drawsome1/Carousel/Team Assignments/Team Assignment 3/Files/StateMachine.pdf

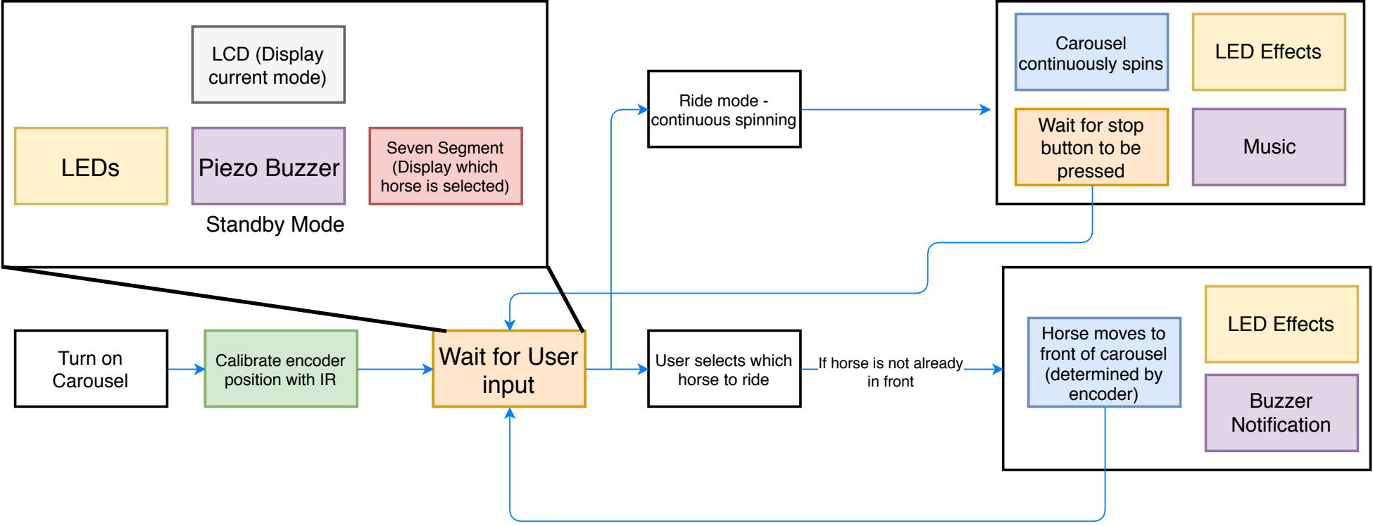
[picture p5: figure]
Standby Mode; Turn on Carousel; Calibrate encoder position with IR; Wait for User input; LEDs; Piezo Buzzer; User selects which horse to ride; Horse moves to front of carousel (determined by encoder); LED Effects; Seven Segment (Display which horse is selected); Buzzer Notification; Ride mode - continuous spinning; If horse is not already in front; Music; Carousel continuously spins; Wait for stop button to be pressed; LCD (Display current mode)

Module 1: LCD

Module 2: DC
Motor with
Encoder

Module 3: IR
Sensor

Module 4:

Buttons | Module 5: LEDs | Module 6: Seven Segment

Module 7: Piezo
Buzzer

## ECE 188 Team 1 State Machine
