drawsome1/Carousel/Codes/TeamAssignment3/PIDSineWave.PNG

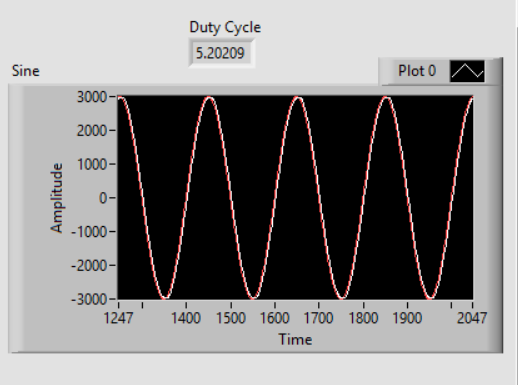
Codes/TeamAssignment3/PIDSineWave.PNG
