drawsome1/Carousel/Codes/TeamAssignment3/sinewave.PNG

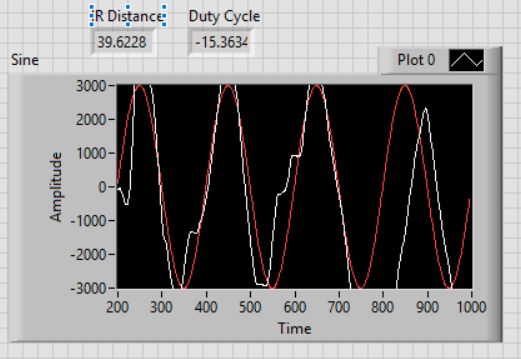
Codes/TeamAssignment3/sinewave.PNG
