drawsome1/Carousel/Pictures/5_kingdoms_disney_carrousel_dlp_canopy.jpg

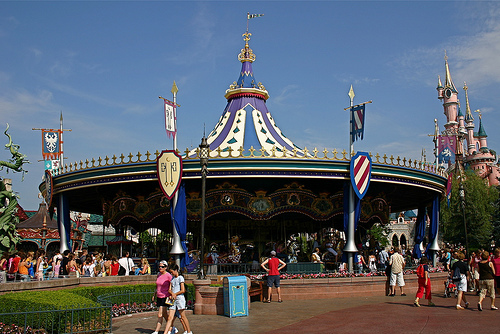
Pictures/5_kingdoms_disney_carrousel_dlp_canopy.jpg
