drawsome1/Carousel/Pictures/20180425_105059.jpg

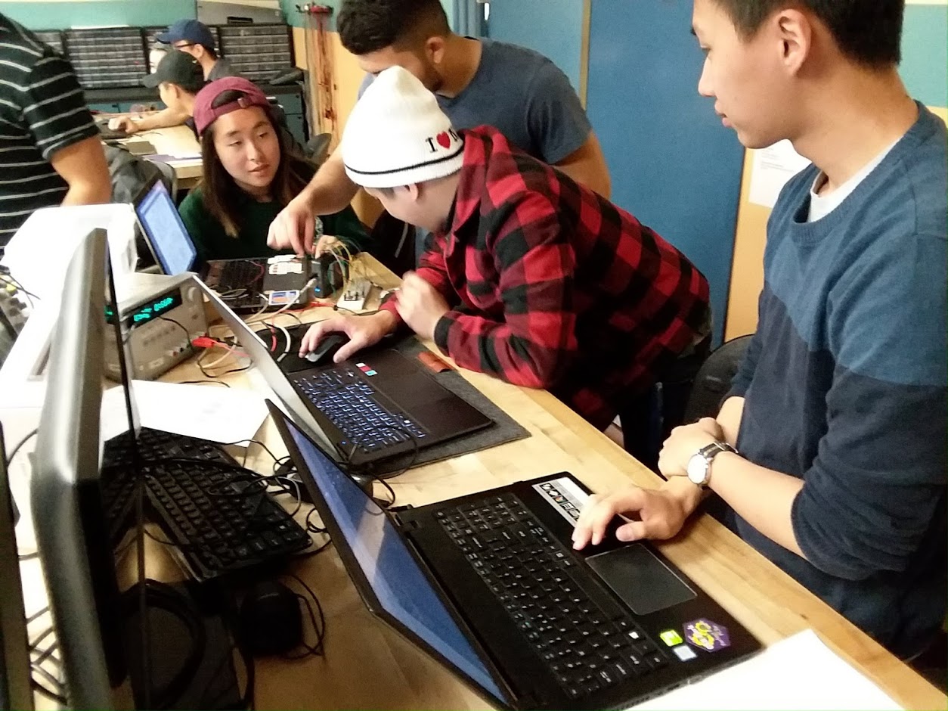
Pictures/20180425_105059.jpg
