drawsome1/Carousel/Pictures/20180425_105112.jpg

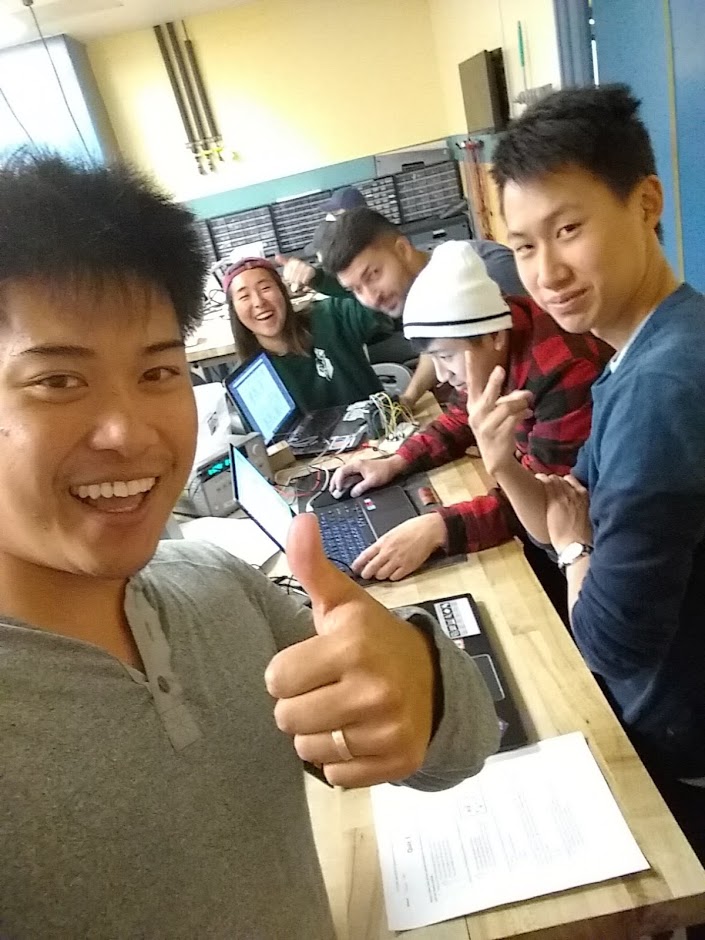
Pictures/20180425_105112.jpg
