drawsome1/Carousel/Pictures/bevel gear.jpg

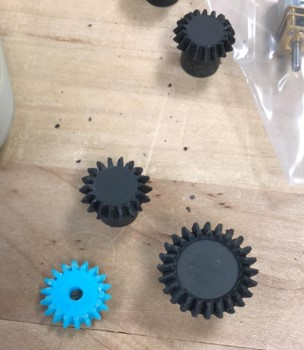
Pictures/bevel gear.jpg
