drawsome1/Carousel/Pictures/bottom box skeleton.png

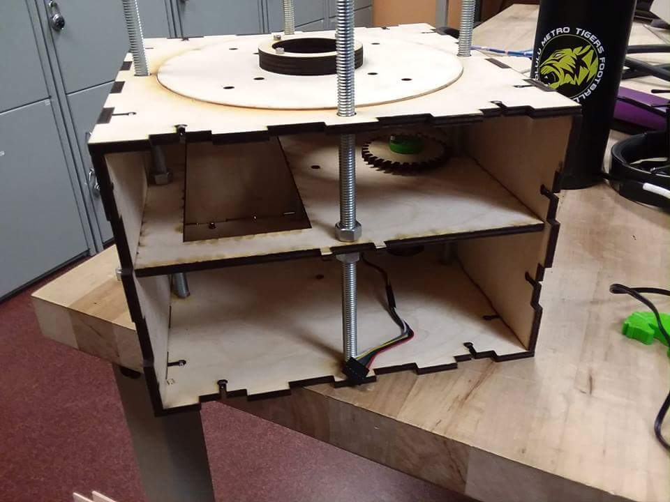
Pictures/bottom box skeleton.png
