drawsome1/Carousel/Pictures/carousel.png

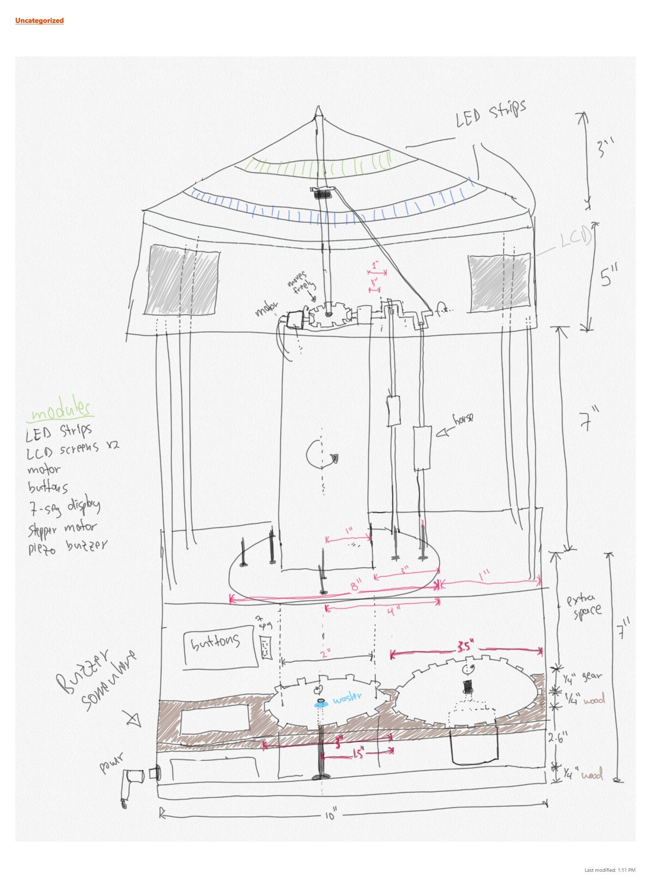
Pictures/carousel.png
