drawsome1/Carousel/Pictures/Final.gif

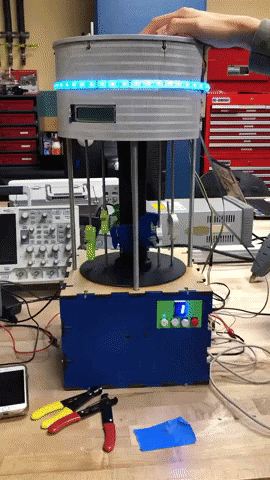
Pictures/Final.gif
