drawsome1/Carousel/Pictures/full system.jpg

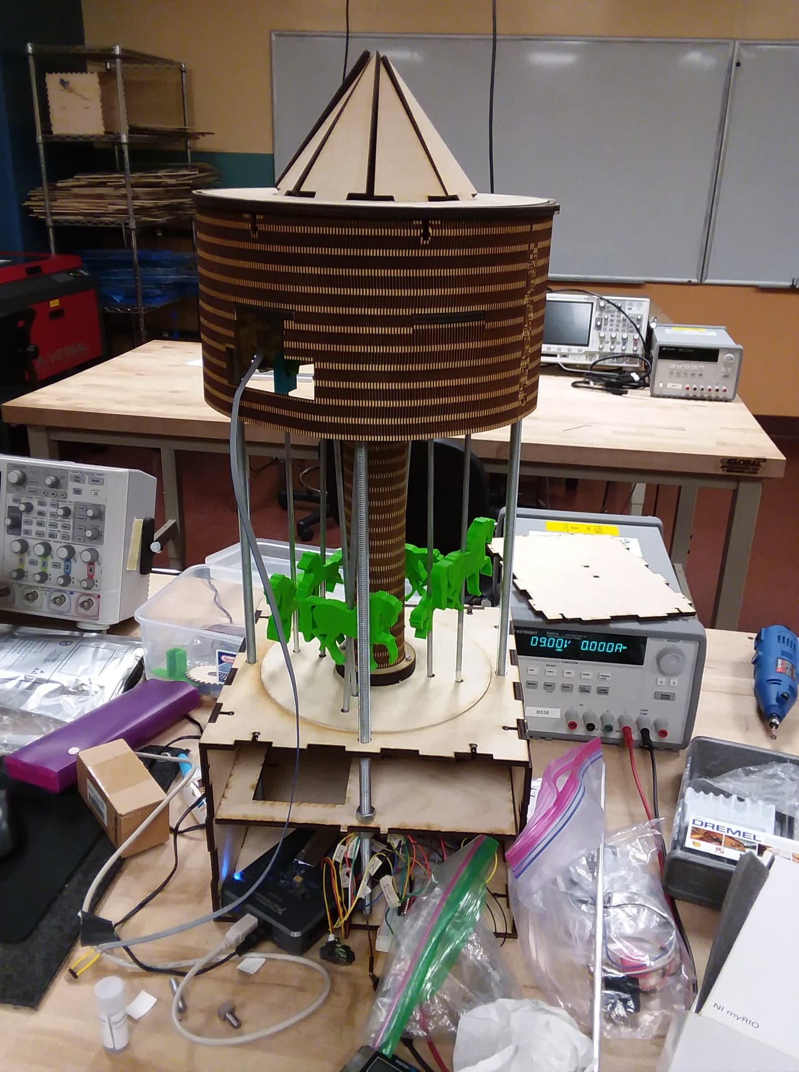
Pictures/full system.jpg
