drawsome1/Carousel/Pictures/gear 1.png

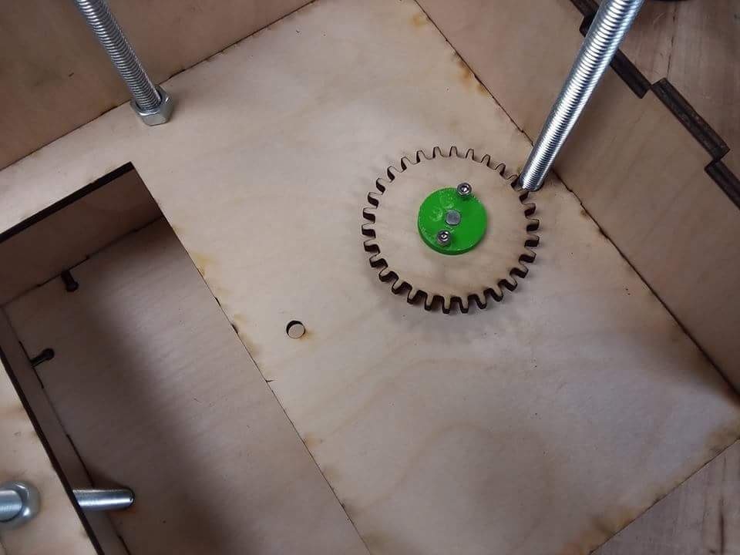
Pictures/gear 1.png
