drawsome1/Carousel/Pictures/horses on system.png

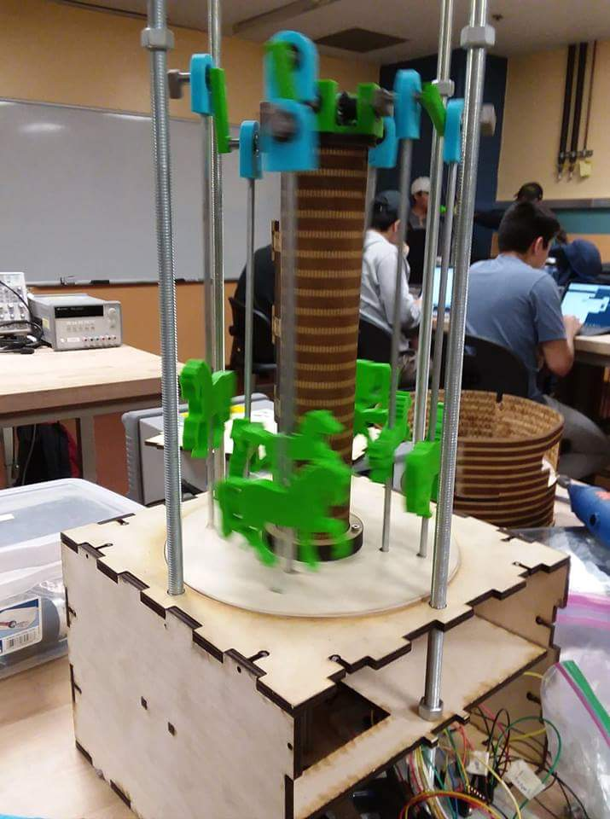
Pictures/horses on system.png
