drawsome1/Carousel/Pictures/rough sketch base.jpg

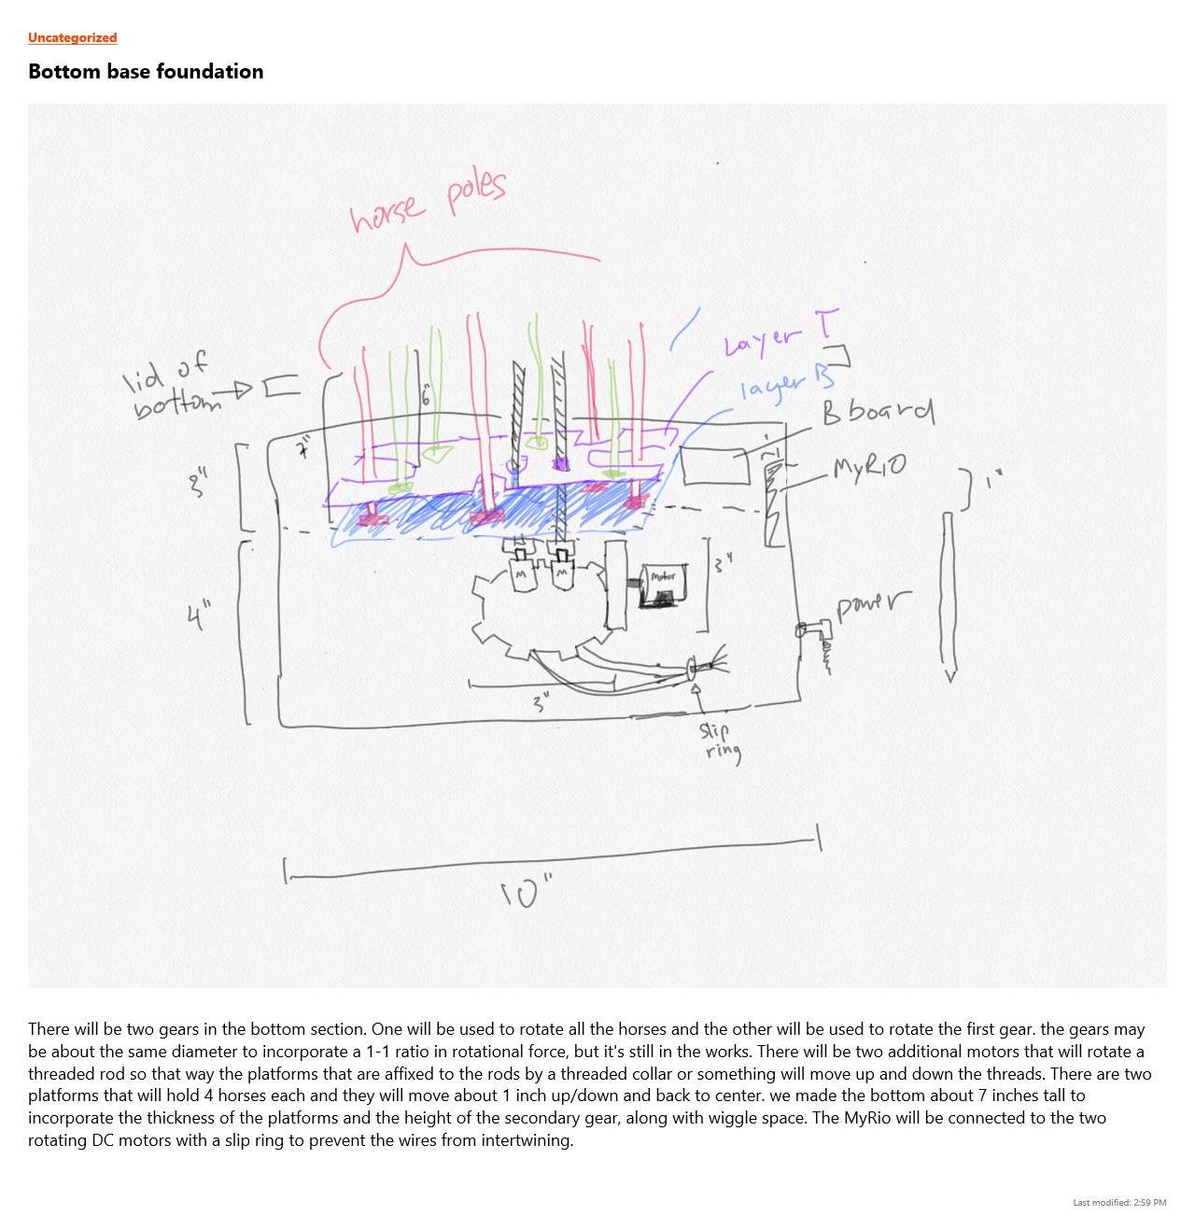
Pictures/rough sketch base.jpg
