drawsome1/Carousel/Pictures/rough sketch system.jpg

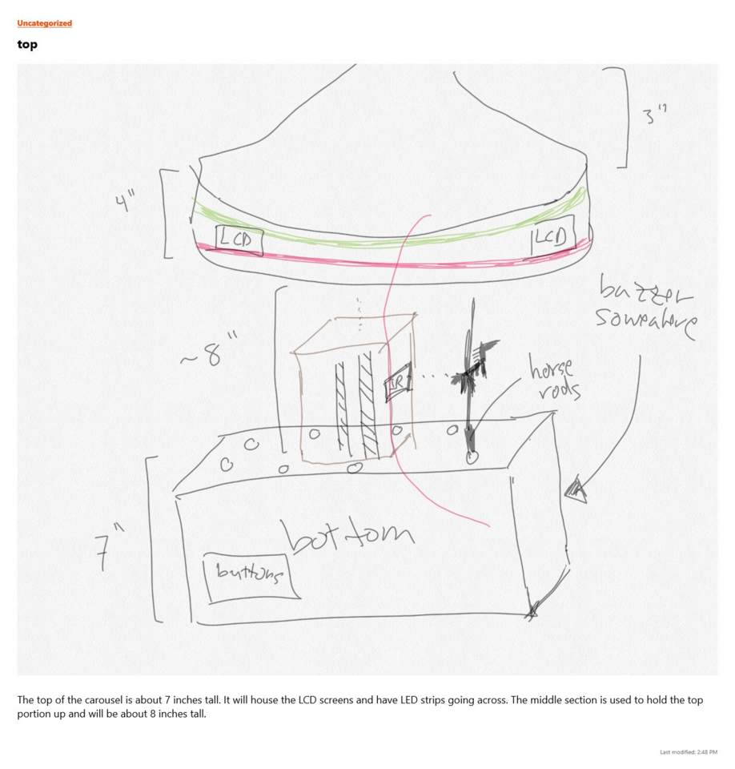
Pictures/rough sketch system.jpg
