drawsome1/Carousel/Pictures/sanding down rod.png

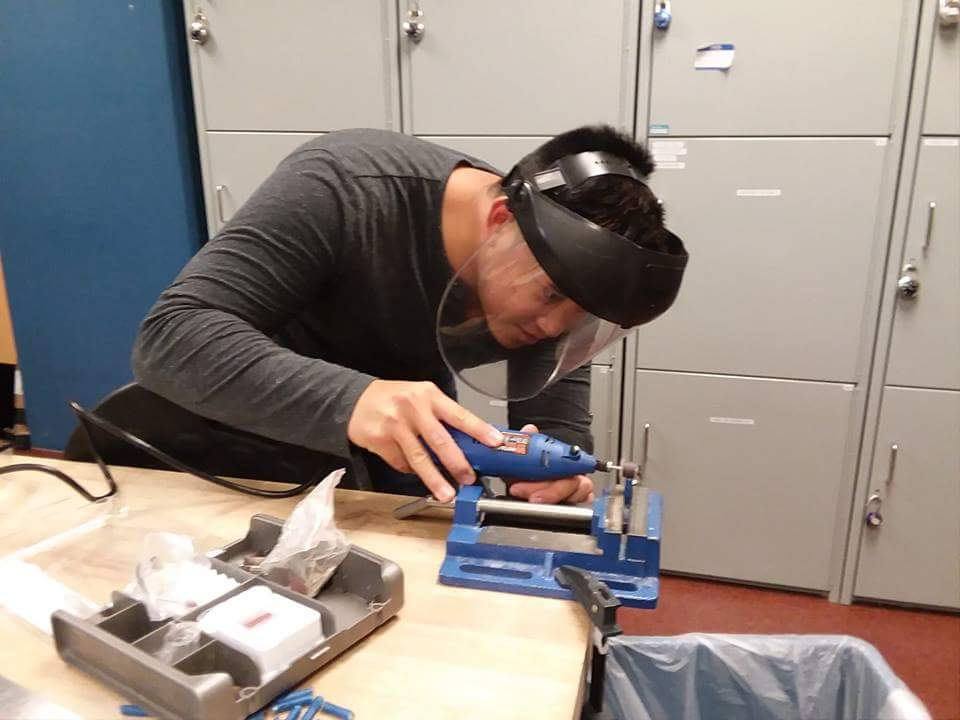
Pictures/sanding down rod.png
