drawsome1/Carousel/Pictures/side view.png

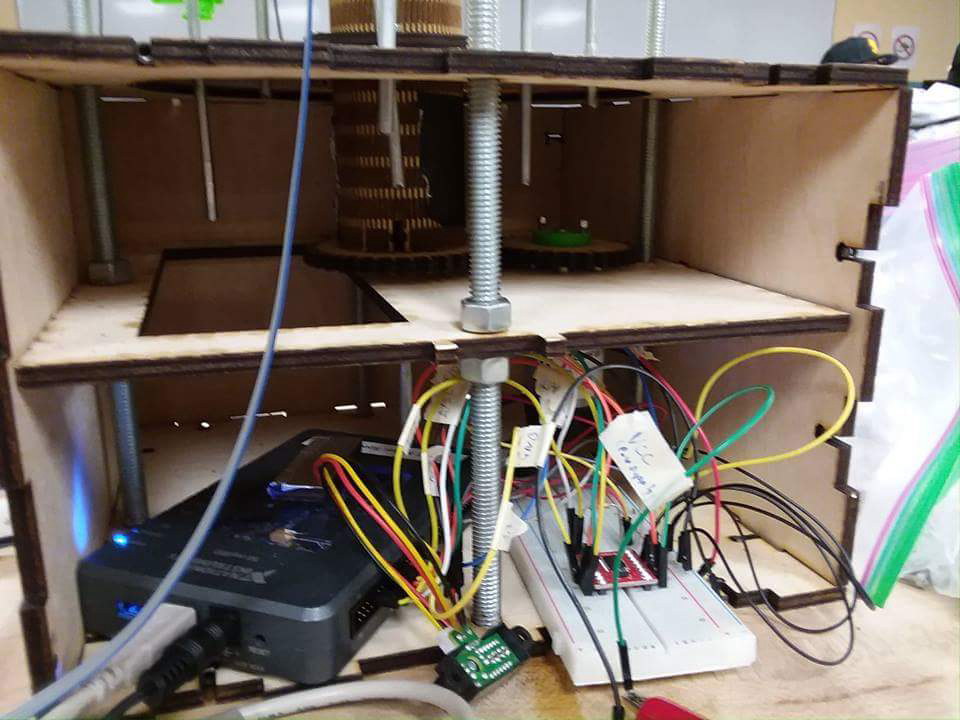
Pictures/side view.png
