drawsome1/Carousel/Pictures/top.png

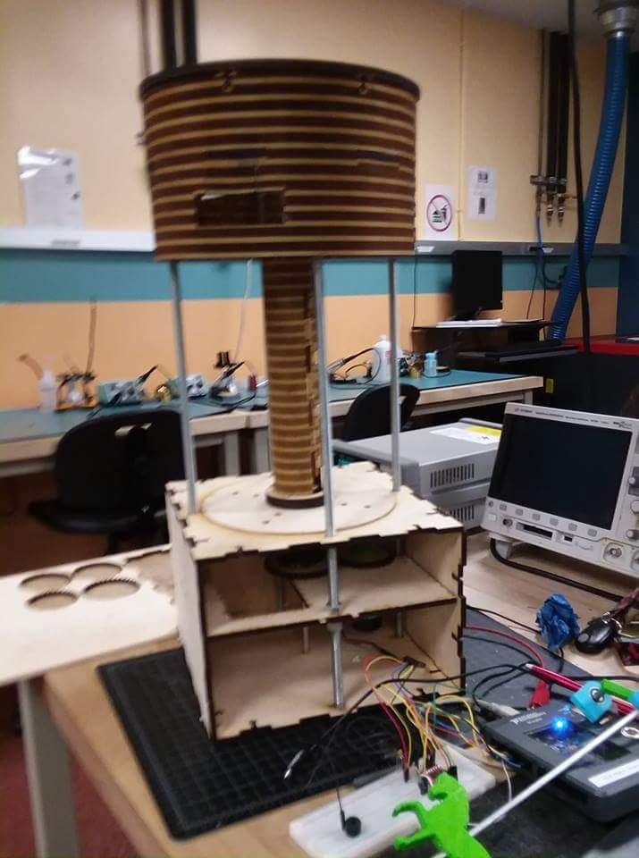
Pictures/top.png
