drawsome1/Carousel/Pictures/workstation.png

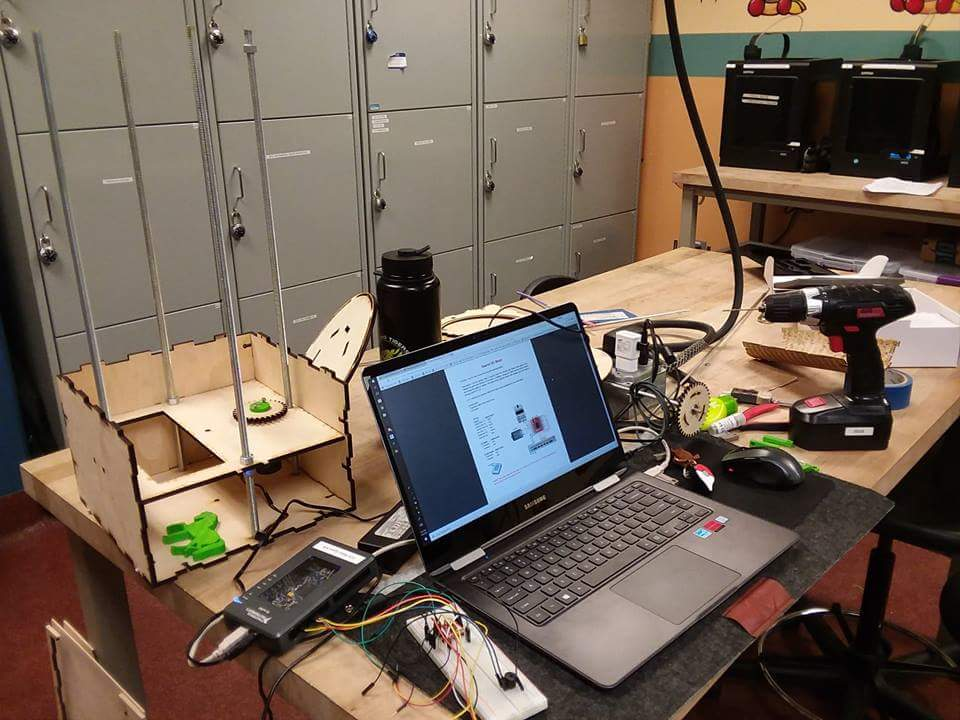
Pictures/workstation.png
