drawsome1/Carousel/Team Assignments/Team Assignment 2/full system front.png

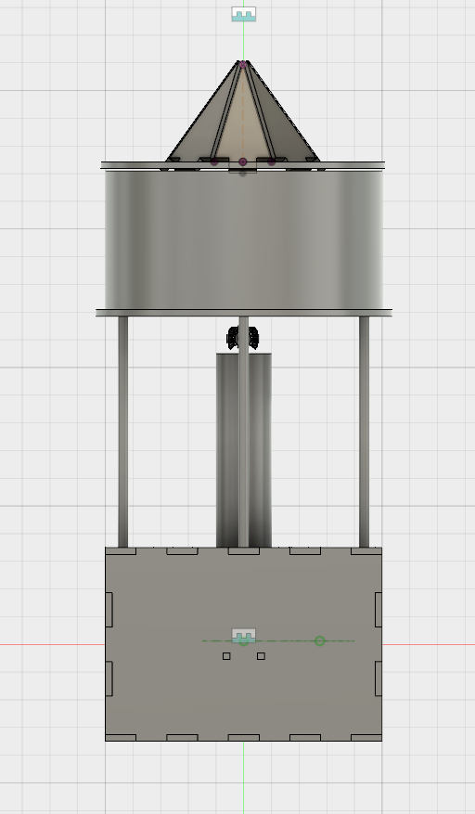
Team Assignments/Team Assignment 2/full system front.png
