drawsome1/Carousel/Team Assignments/Team Assignment 2/full system isometric.png

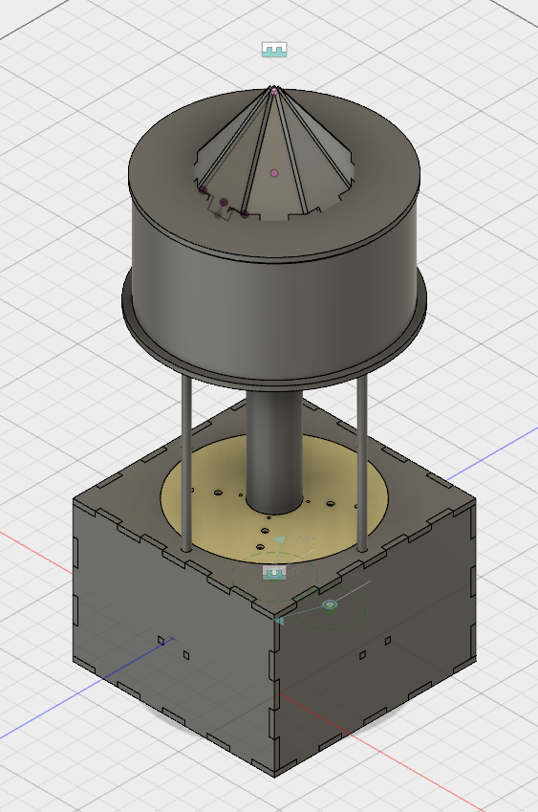
Team Assignments/Team Assignment 2/full system isometric.png
