drawsome1/Carousel/Team Assignments/Team Assignment 2/Parts/laser cut/back_bottom.pdf

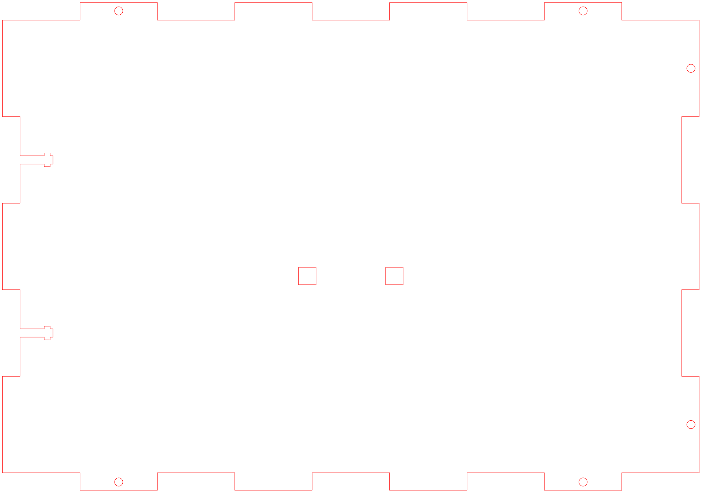
[picture p26: figure]
