drawsome1/Carousel/Team Assignments/Team Assignment 2/Parts/laser cut/center rod support.pdf

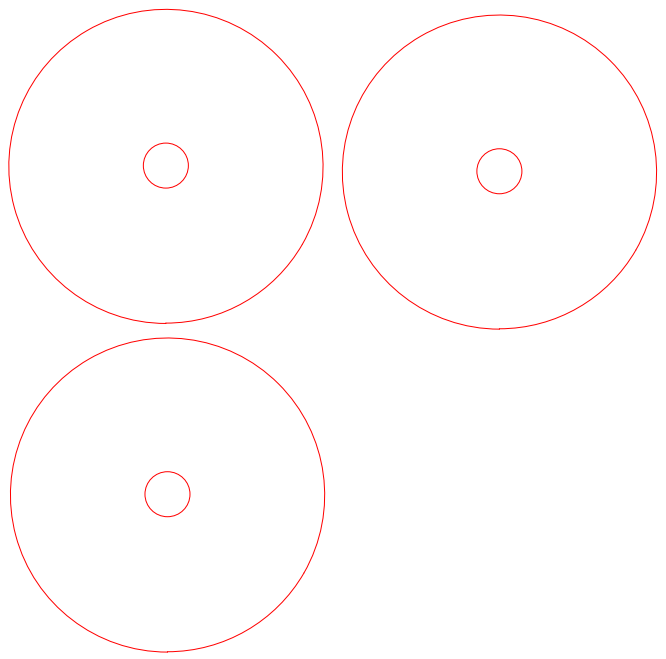
[picture p27: figure]
