drawsome1/Carousel/Team Assignments/Team Assignment 2/Parts/laser cut/front+middle_bottom + tent(6).pdf

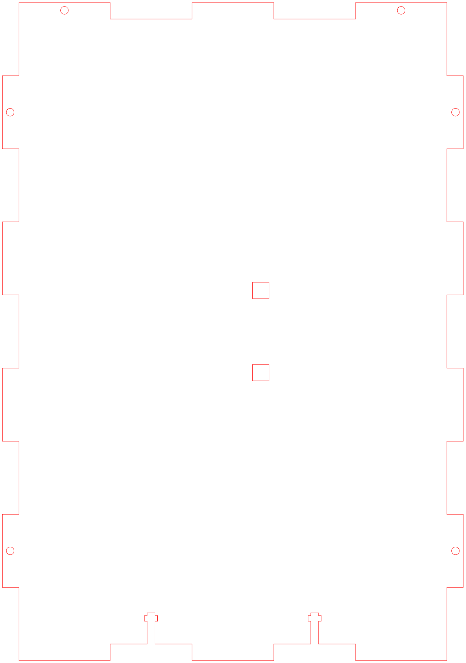
[picture p28: figure]
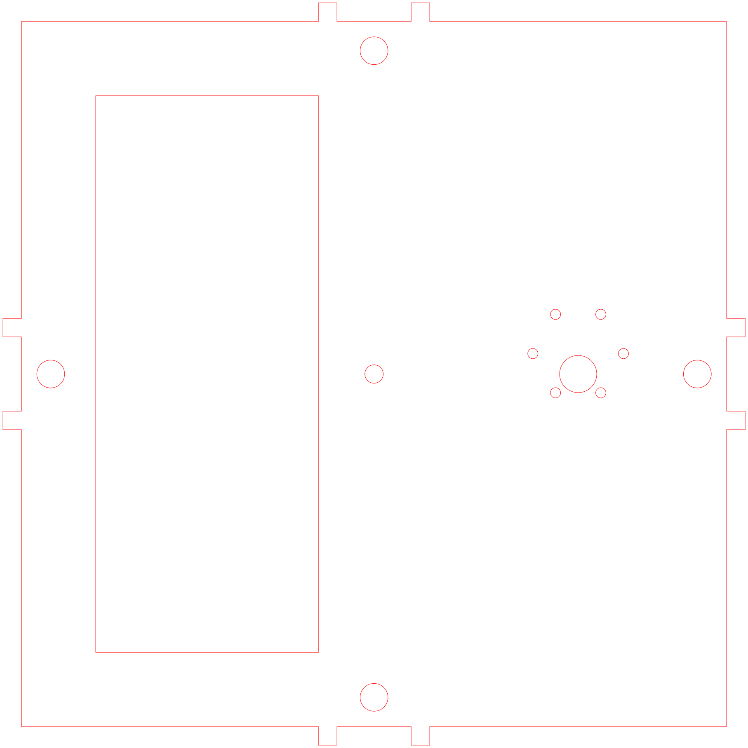
[picture p29: figure]
