drawsome1/Carousel/Team Assignments/Team Assignment 2/Parts/laser cut/rotating circle.pdf

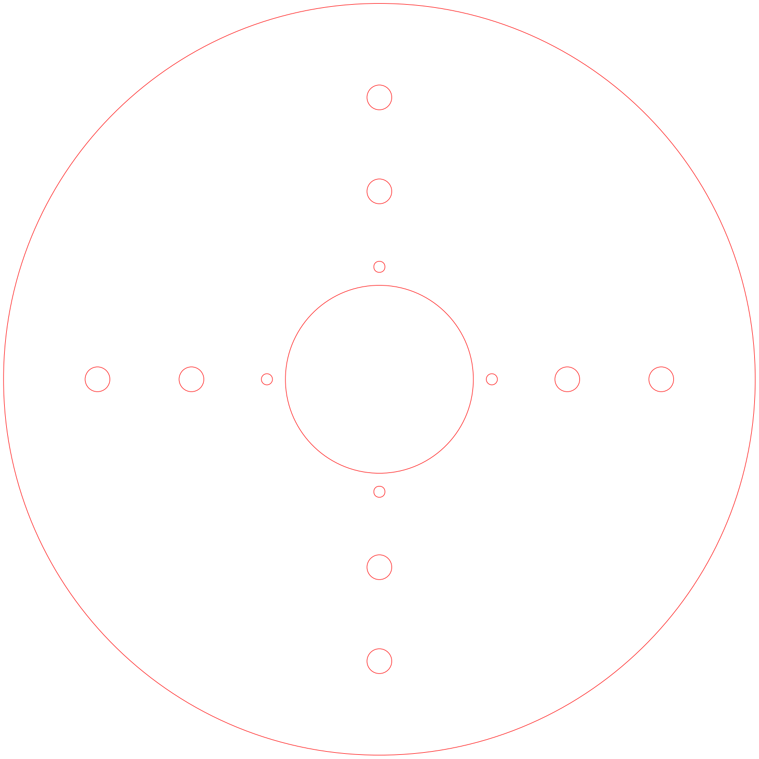
[picture p30: figure]
