drawsome1/Carousel/Team Assignments/Team Assignment 2/Parts/laser cut/top+bottom_bottom.pdf

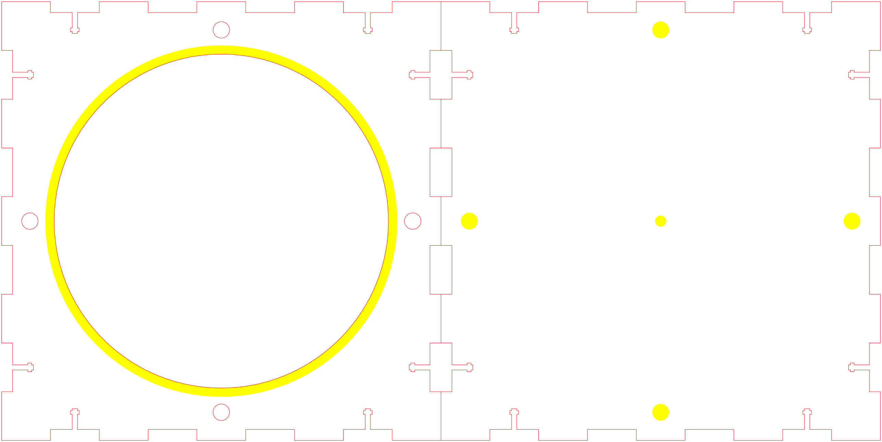
[picture p31: figure]
