drawsome1/Carousel/Team Assignments/Team Assignment 2/Parts/3D print/BevelGearVertical.stl

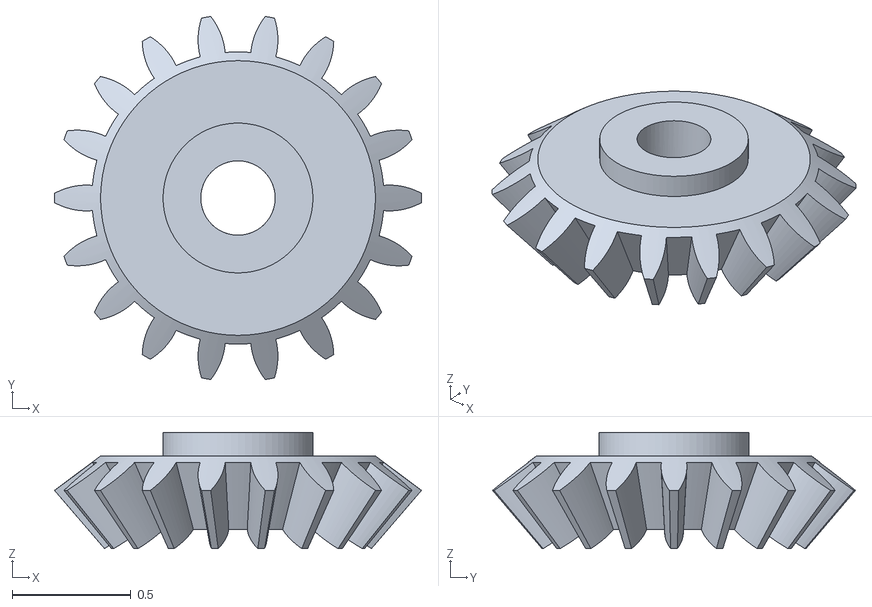
[picture p32: CAD file, 2018-07-12]
Team Assignments/Team Assignment 2/Parts/3D print/BevelGearVertical.stl
1.54 x 1.53 x 0.489
