drawsome1/Carousel/Team Assignments/Team Assignment 2/Parts/bottom case/spur gear (30t).igs

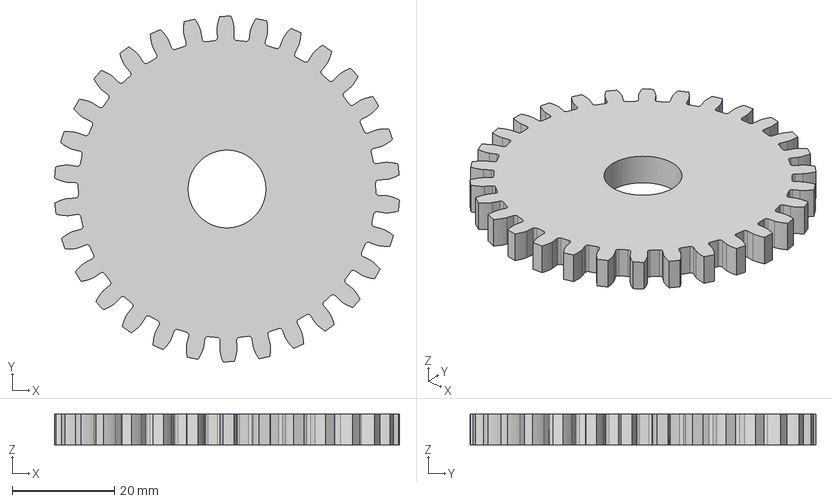
[picture p33: CAD file, 2018-07-12]
Team Assignments/Team Assignment 2/Parts/bottom case/spur gear (30t).igs
67.6 x 67.7 x 6.00 mm
