drawsome1/Carousel/Team Assignments/Team Assignment 2/Parts/CRANKSHAFT one in.SLDPRT

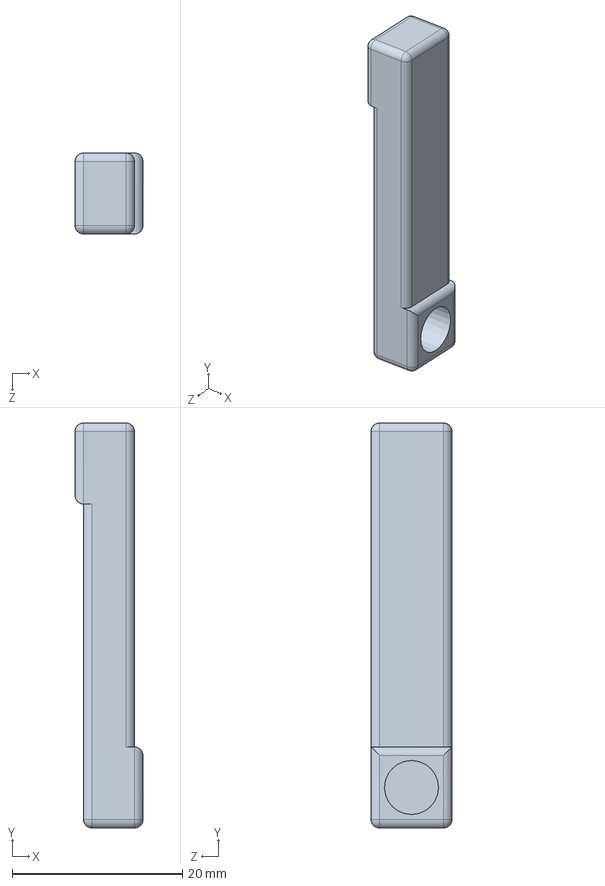
[picture p34: CAD file, 2018-07-12]
Team Assignments/Team Assignment 2/Parts/CRANKSHAFT one in.SLDPRT
8.00 x 47.6 x 9.53 mm
