drawsome1/Carousel/Team Assignments/Team Assignment 2/Parts/DXF/spurGear36t.DXF

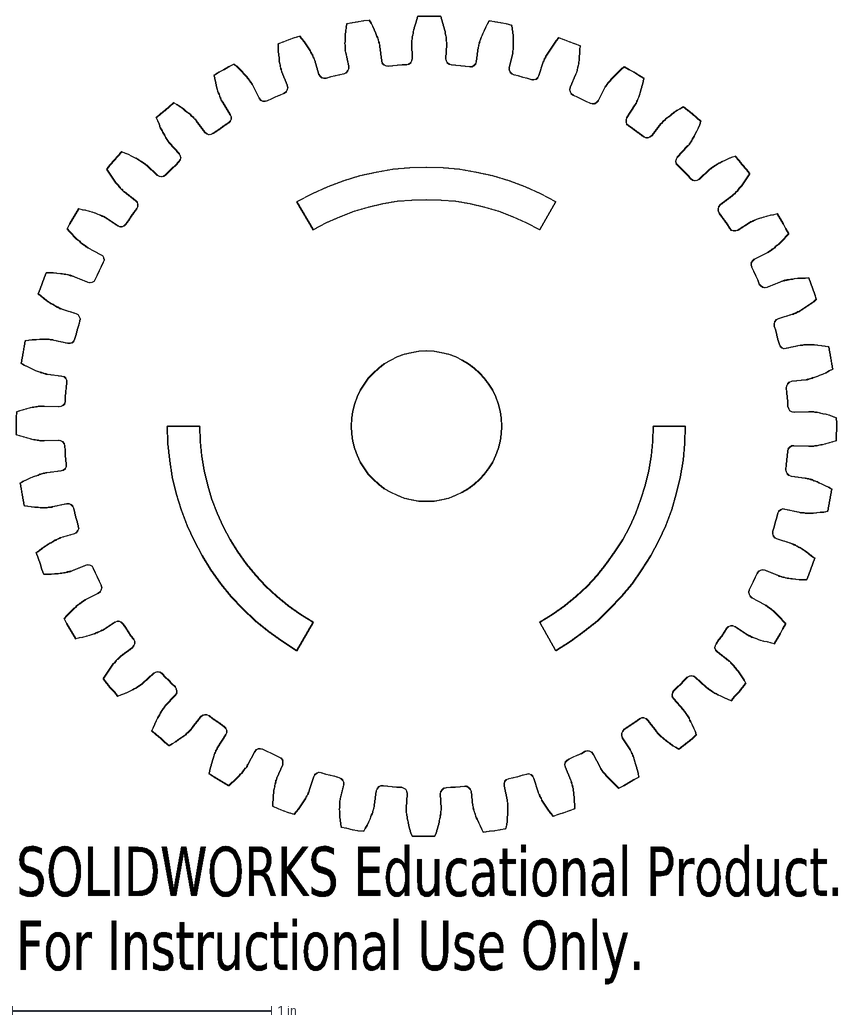
[picture p35: CAD file, 2018-07-12]
Team Assignments/Team Assignment 2/Parts/DXF/spurGear36t.DXF
SOLIDWORKS Educational Product.
For Instructional Use Only.
