drawsome1/Carousel/Team Assignments/Team Assignment 2/Parts/bottom case/top.igs

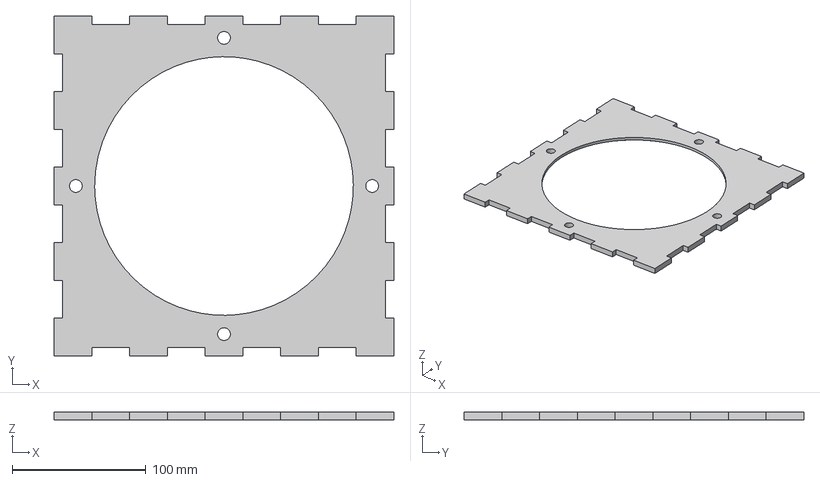
[picture p36: CAD file, 2018-07-12]
Team Assignments/Team Assignment 2/Parts/bottom case/top.igs
254.0 x 254.0 x 6.00 mm
