drawsome1/Carousel/Team Assignments/Team Assignment 2/Parts/DXF/middleTop.DXF

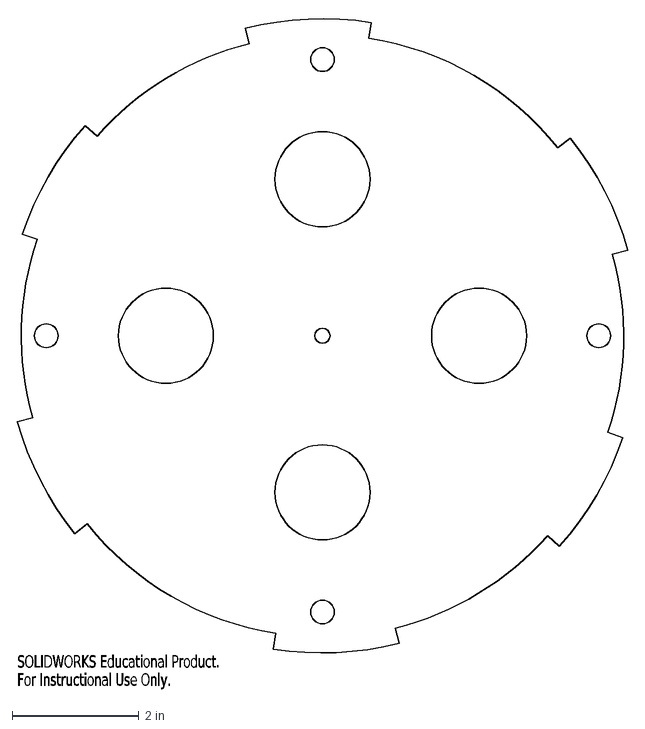
[picture p37: CAD file, 2018-07-12]
Team Assignments/Team Assignment 2/Parts/DXF/middleTop.DXF
SOLIDWORKS Educational Product.
For Instructional Use Only.
