drawsome1/Carousel/Team Assignments/Team Assignment 2/Parts/top tent.igs

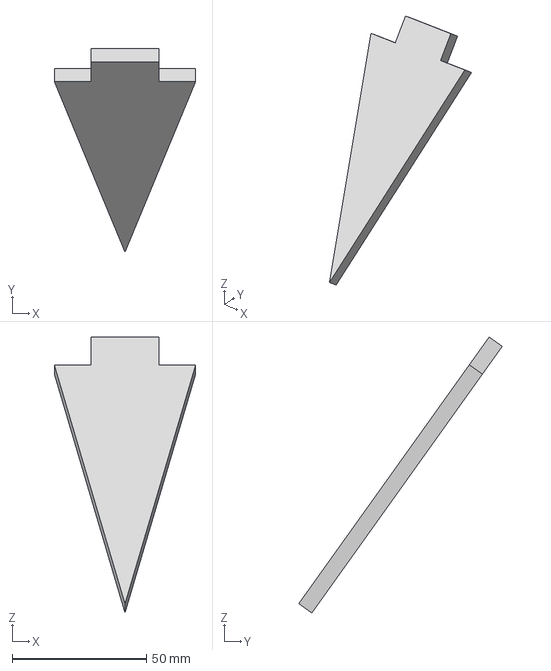
[picture p38: CAD file, 2018-07-12]
Team Assignments/Team Assignment 2/Parts/top tent.igs
52.6 x 75.8 x 102.7 mm
