drawsome1/Carousel/Team Assignments/Team Assignment 2/Parts/3D print/bearingadapter.STL

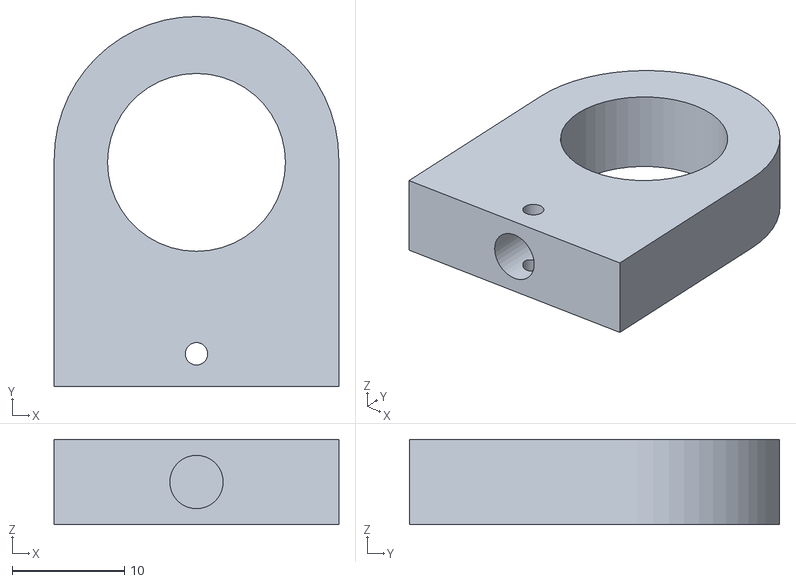
[picture p39: CAD file, 2018-07-12]
Team Assignments/Team Assignment 2/Parts/3D print/bearingadapter.STL
25.4 x 33.0 x 7.62
