drawsome1/Carousel/Team Assignments/Team Assignment 2/Parts/centerrodv3.IGS

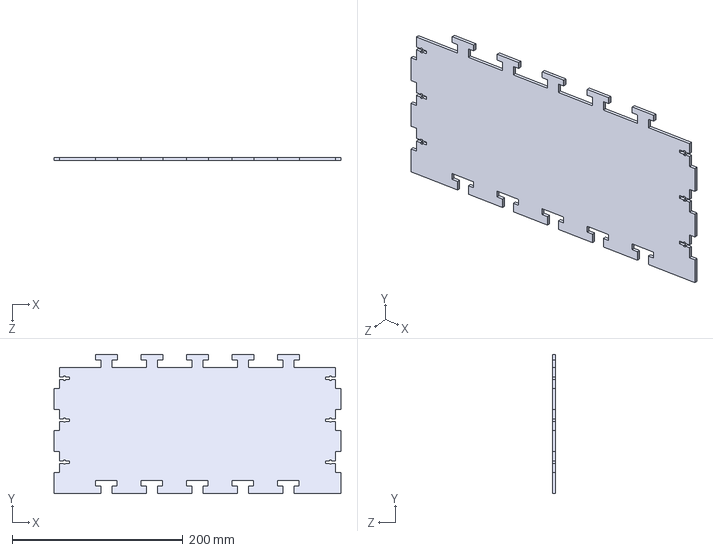
[picture p41: CAD file, 2018-07-12]
Team Assignments/Team Assignment 2/Parts/centerrodv3.IGS
336.5 x 163.1 x 3.17 mm
