drawsome1/Carousel/Team Assignments/Team Assignment 2/Parts/DXF/top.DXF

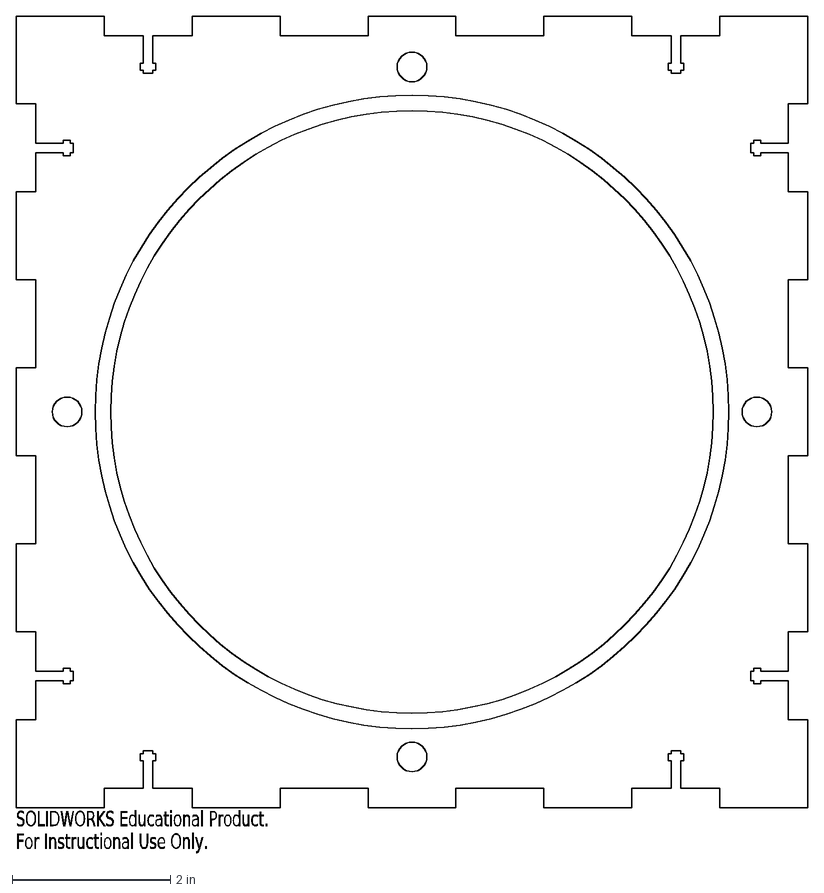
[picture p42: CAD file, 2018-07-12]
Team Assignments/Team Assignment 2/Parts/DXF/top.DXF
SOLIDWORKS Educational Product.
For Instructional Use Only.
