drawsome1/Carousel/Team Assignments/Team Assignment 2/Parts/bottom case/bottom.igs

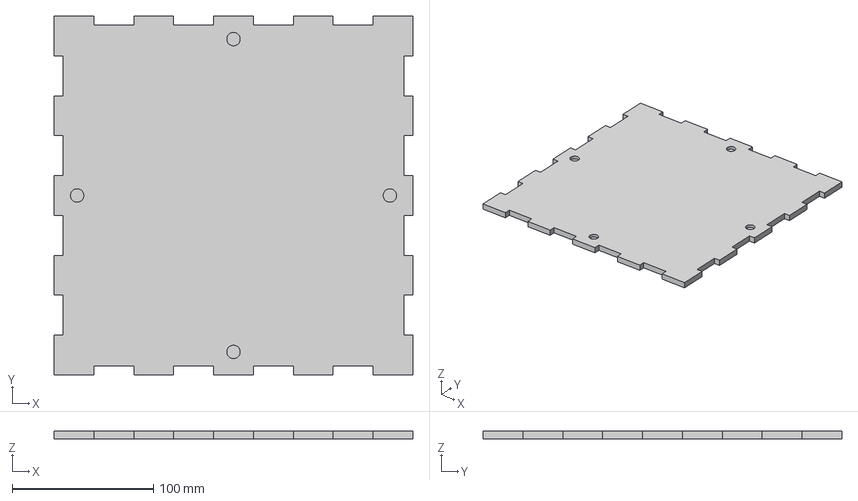
[picture p43: CAD file, 2018-07-12]
Team Assignments/Team Assignment 2/Parts/bottom case/bottom.igs
254.0 x 254.0 x 6.00 mm
