drawsome1/Carousel/Team Assignments/Team Assignment 2/Parts/circle.SLDPRT

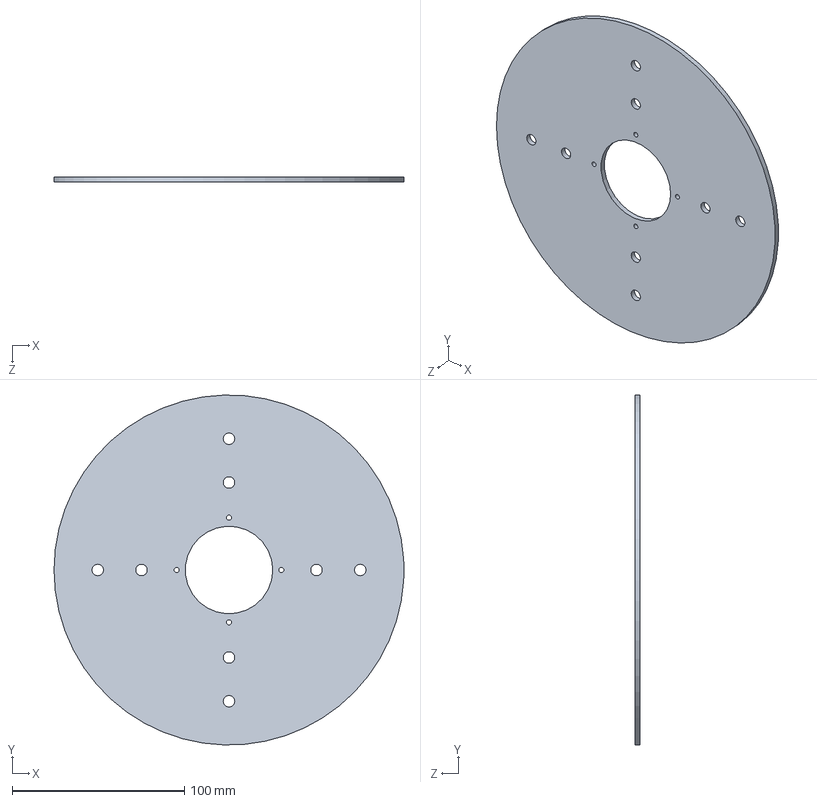
[picture p44: CAD file, 2018-07-12]
Team Assignments/Team Assignment 2/Parts/circle.SLDPRT
203.2 x 203.1 x 3.17 mm
