drawsome1/Carousel/Team Assignments/Team Assignment 2/Parts/DXF/topcap.DXF

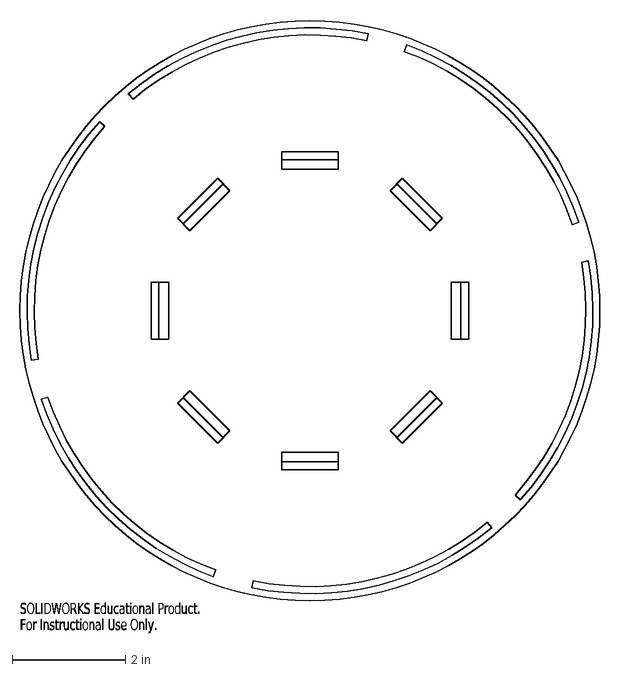
[picture p45: CAD file, 2018-07-12]
Team Assignments/Team Assignment 2/Parts/DXF/topcap.DXF
SOLIDWORKS Educational Product.
For Instructional Use Only.
