drawsome1/Carousel/Team Assignments/Team Assignment 2/Parts/bottom case/side walls.igs

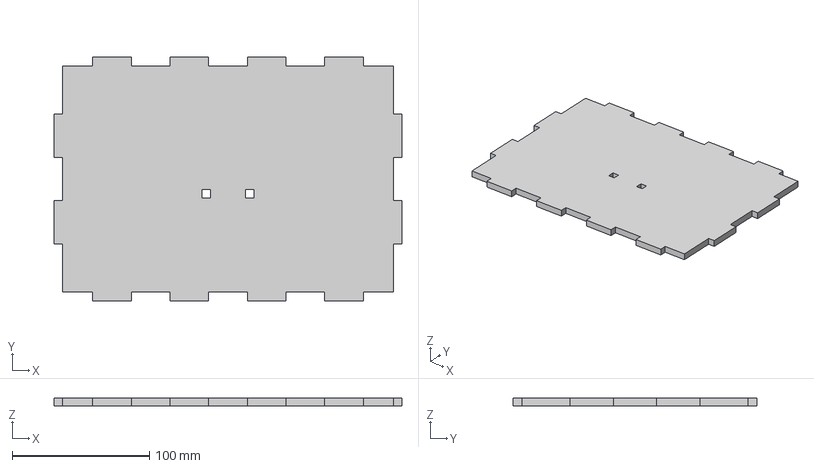
[picture p46: CAD file, 2018-07-12]
Team Assignments/Team Assignment 2/Parts/bottom case/side walls.igs
254.0 x 177.8 x 6.00 mm
