drawsome1/Carousel/Team Assignments/Team Assignment 2/Parts/DXF/front_back.DXF

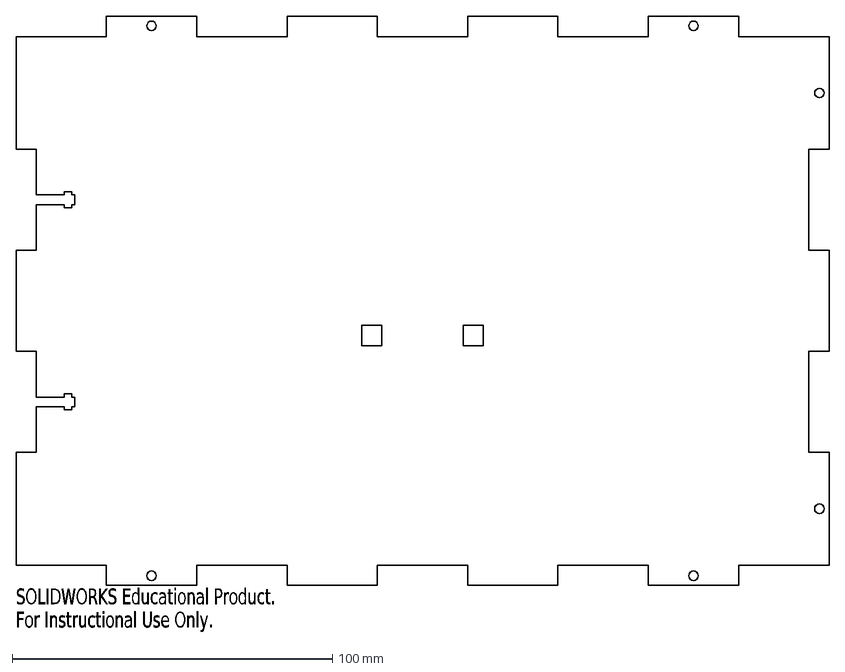
[picture p47: CAD file, 2018-07-12]
Team Assignments/Team Assignment 2/Parts/DXF/front_back.DXF
SOLIDWORKS Educational Product.
For Instructional Use Only.
