drawsome1/Carousel/Team Assignments/Team Assignment 2/Parts/DXF/middlePlatform_bottom.DXF

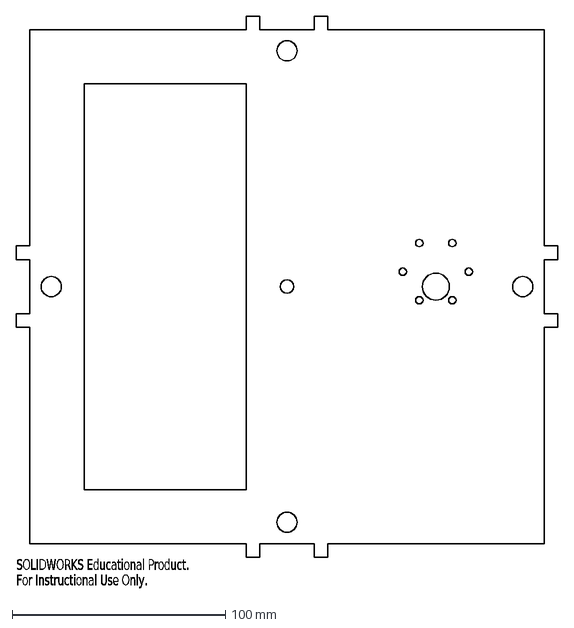
[picture p49: CAD file, 2018-07-12]
Team Assignments/Team Assignment 2/Parts/DXF/middlePlatform_bottom.DXF
SOLIDWORKS Educational Product.
For Instructional Use Only.
