drawsome1/Carousel/Team Assignments/Team Assignment 2/Parts/LCD Cover, half.SLDPRT

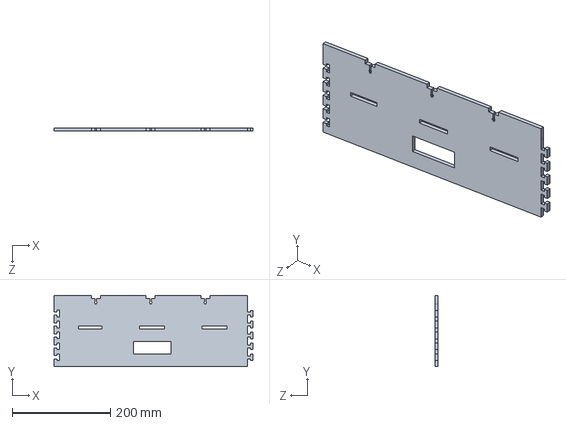
[picture p50: CAD file, 2018-07-12]
Team Assignments/Team Assignment 2/Parts/LCD Cover, half.SLDPRT
404.5 x 145.0 x 6.35 mm
