drawsome1/Carousel/Team Assignments/Team Assignment 2/Parts/bottom case/spur gear (36t).igs

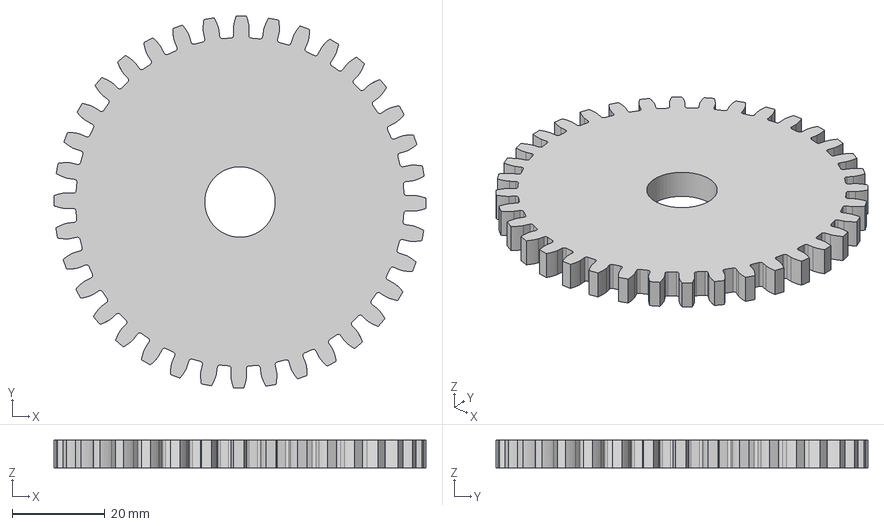
[picture p51: CAD file, 2018-07-12]
Team Assignments/Team Assignment 2/Parts/bottom case/spur gear (36t).igs
80.4 x 80.4 x 6.00 mm
