drawsome1/Carousel/Team Assignments/Team Assignment 2/Parts/DXF/sideWall.DXF

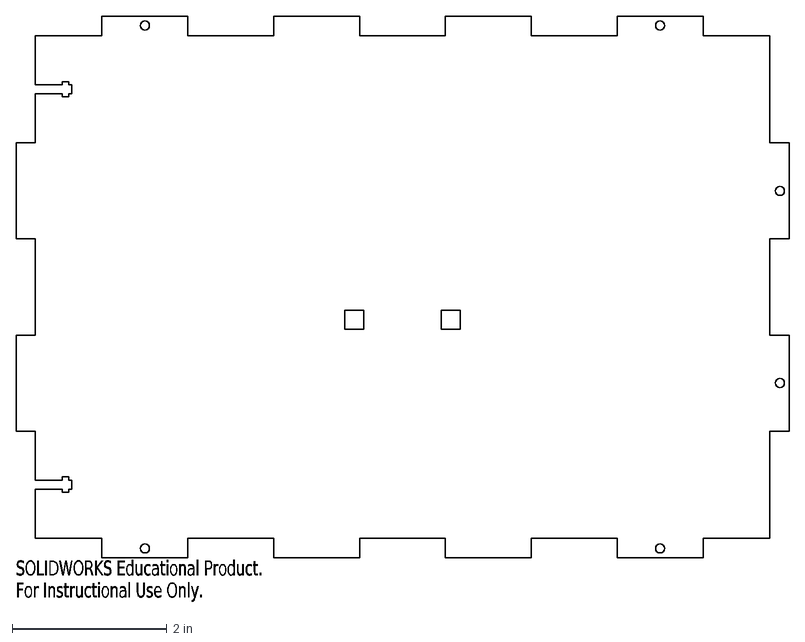
[picture p52: CAD file, 2018-07-12]
Team Assignments/Team Assignment 2/Parts/DXF/sideWall.DXF
SOLIDWORKS Educational Product.
For Instructional Use Only.
