drawsome1/Carousel/Team Assignments/Team Assignment 2/Parts/stackedcircle.SLDPRT

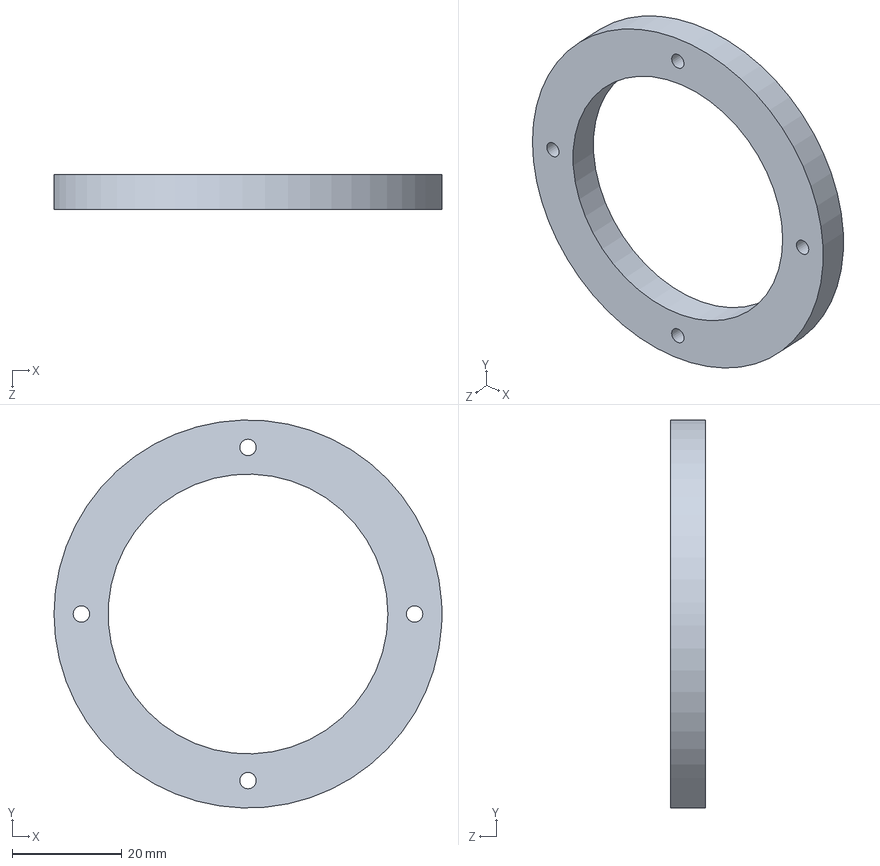
[picture p53: CAD file, 2018-07-12]
Team Assignments/Team Assignment 2/Parts/stackedcircle.SLDPRT
70.8 x 70.8 x 6.35 mm
