drawsome1/Carousel/Team Assignments/Team Assignment 2/Parts/CRANKSHAFT half in.SLDPRT

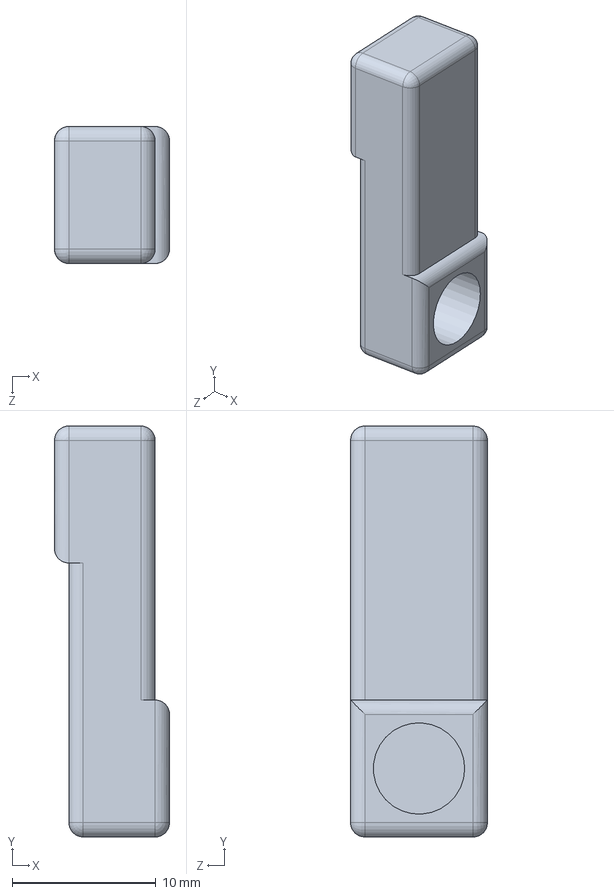
[picture p54: CAD file, 2018-07-12]
Team Assignments/Team Assignment 2/Parts/CRANKSHAFT half in.SLDPRT
8.00 x 28.6 x 9.53 mm
