drawsome1/Carousel/Team Assignments/Team Assignment 2/Parts/DXF/spurGear30t.DXF

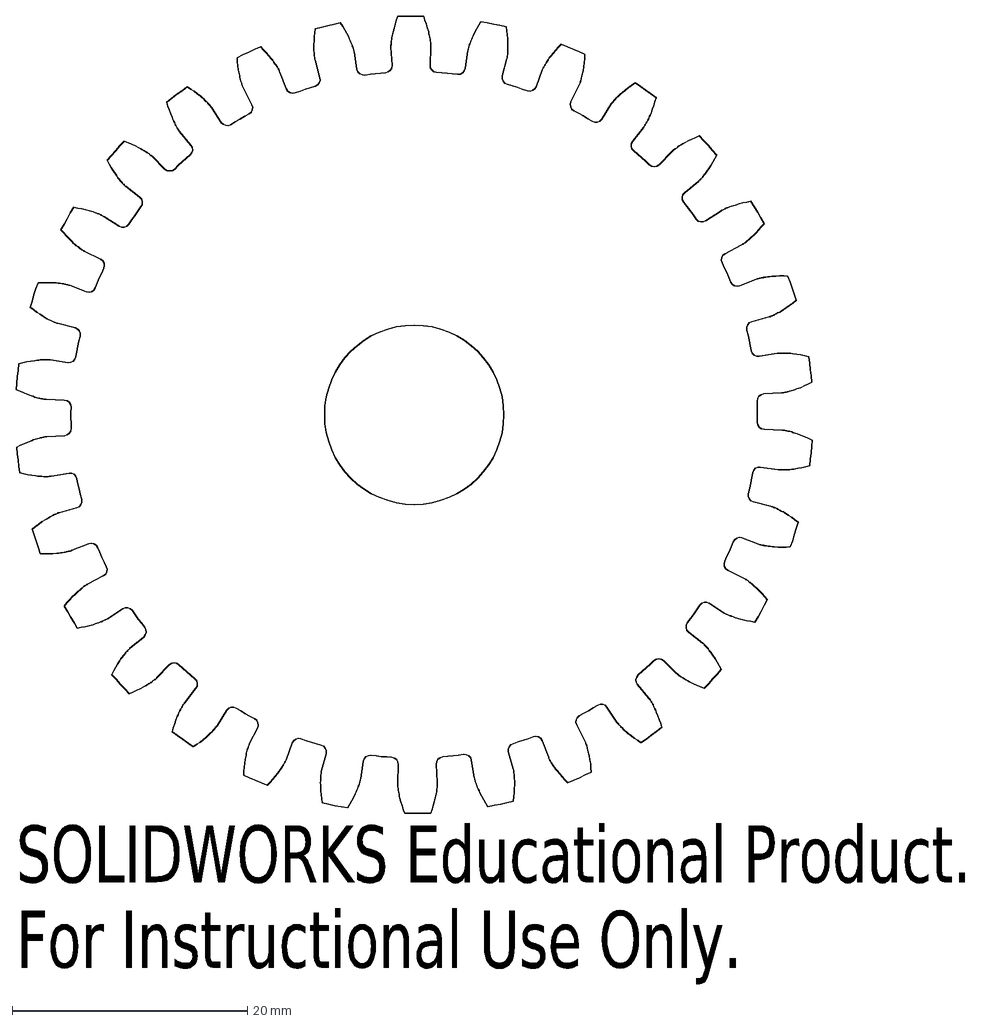
[picture p55: CAD file, 2018-07-12]
Team Assignments/Team Assignment 2/Parts/DXF/spurGear30t.DXF
SOLIDWORKS Educational Product.
For Instructional Use Only.
