drawsome1/Carousel/Team Assignments/Team Assignment 2/Parts/37d-gearmotor-50-70-encoder.step

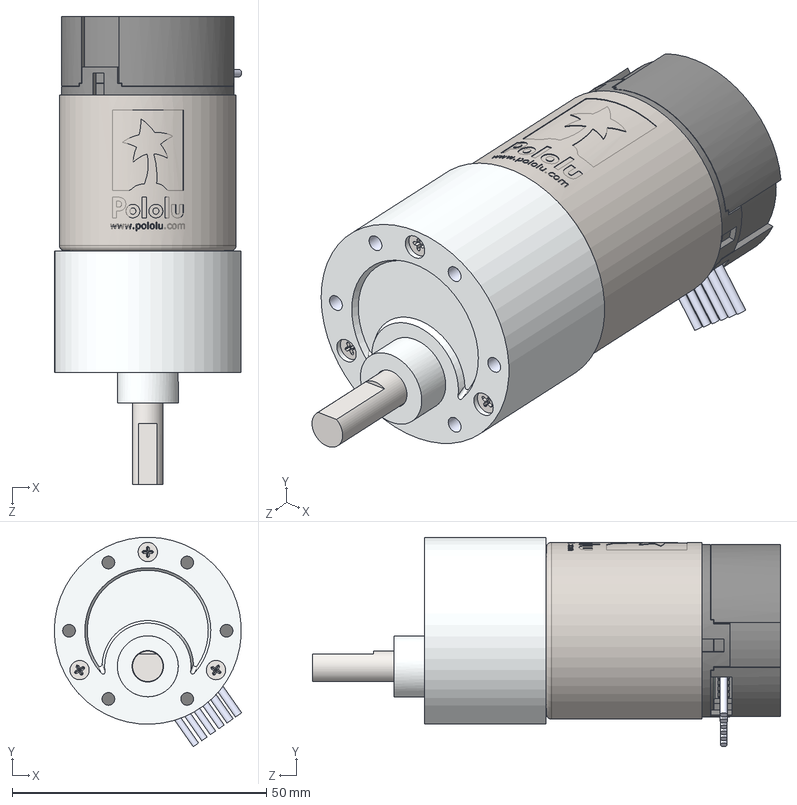
[picture p56: CAD file, 2018-07-12]
Team Assignments/Team Assignment 2/Parts/37d-gearmotor-50-70-encoder.step
36.9 x 41.2 x 92.1 mm
