drawsome1/Carousel/Team Assignments/Team Assignment 2/Parts/DXF/Bottom.DXF

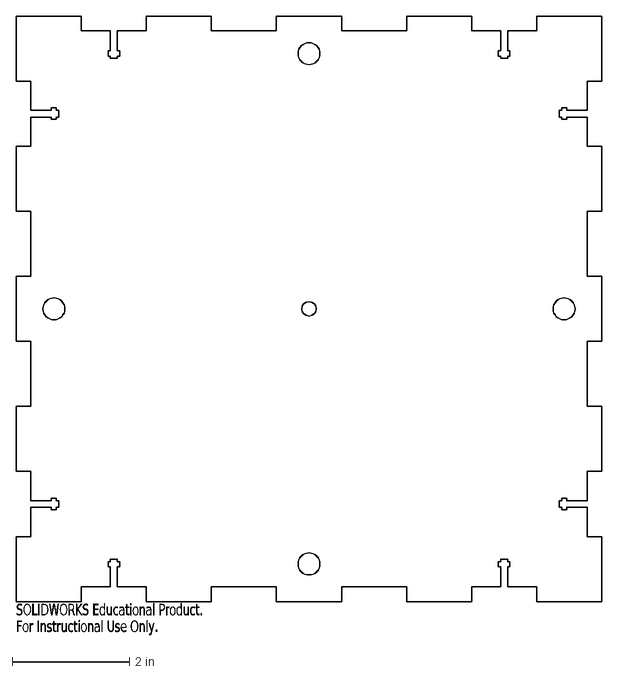
[picture p57: CAD file, 2018-07-12]
Team Assignments/Team Assignment 2/Parts/DXF/Bottom.DXF
SOLIDWORKS Educational Product.
For Instructional Use Only.
