drawsome1/Carousel/Team Assignments/Team Assignment 2/Parts/DXF/tent.DXF

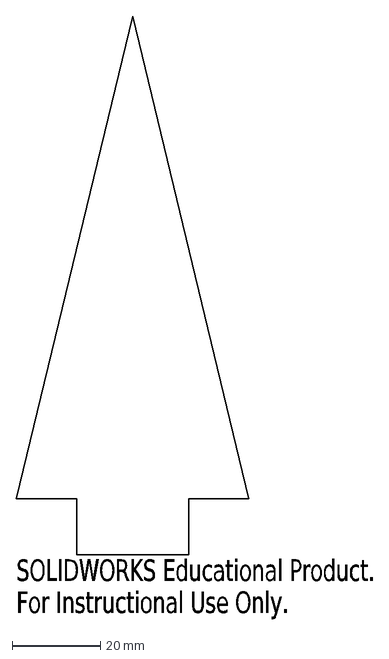
[picture p58: CAD file, 2018-07-12]
Team Assignments/Team Assignment 2/Parts/DXF/tent.DXF
SOLIDWORKS Educational Product.
For Instructional Use Only.
