drawsome1/Carousel/Team Assignments/Team Assignment 2/Parts/bevelGear.igs

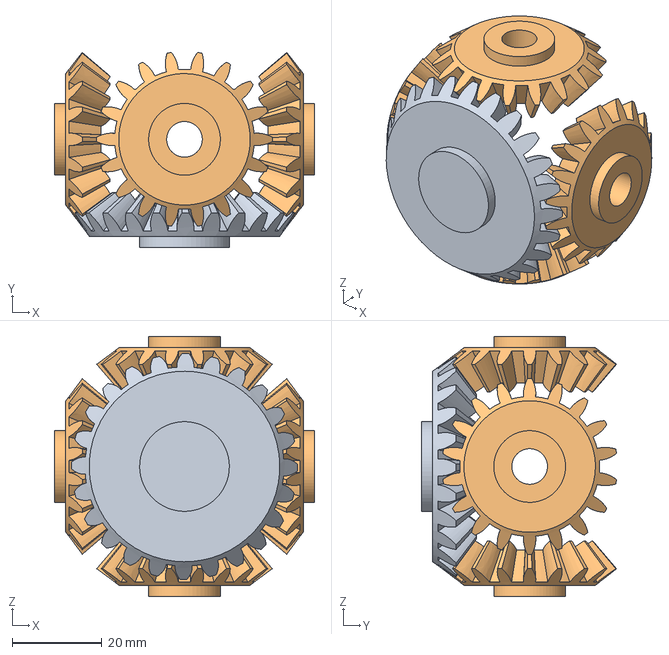
[picture p59: CAD file, 2018-07-12]
Team Assignments/Team Assignment 2/Parts/bevelGear.igs
58.0 x 43.5 x 58.0 mm
