drawsome1/Carousel/Team Assignments/Team Assignment 2/Parts/centerrod.SLDPRT

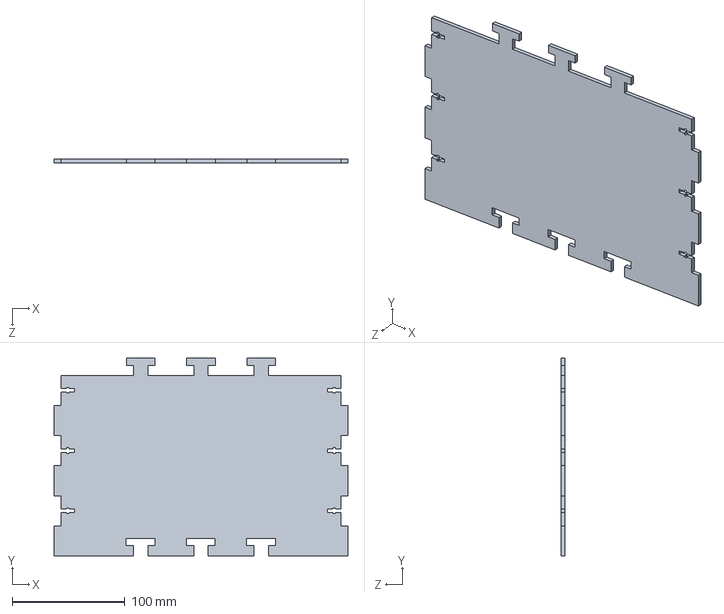
[picture p60: CAD file, 2018-07-12]
Team Assignments/Team Assignment 2/Parts/centerrod.SLDPRT
260.3 x 175.1 x 3.17 mm
