drawsome1/Carousel/(list of files, cad)

Other CAD files:
Team Assignments/Team Assignment 2/Parts/3D print/HORSE.IGS
Team Assignments/Team Assignment 2/Parts/centerrodv2.IGS
Team Assignments/Team Assignment 2/Parts/HORSE IS READY.SLDPRT
Team Assignments/Team Assignment 2/Parts/3D print/HORSE IS READY.STL
Team Assignments/Team Assignment 2/Parts/CRANKSHAFT half in.IGS
Team Assignments/Team Assignment 2/Parts/CRANKSHAFT one in.IGS
Team Assignments/Team Assignment 2/Parts/CRANKSHAFT one in.STL
Team Assignments/Team Assignment 2/Parts/DXF/centerrod.DXF
Team Assignments/Team Assignment 2/Parts/DXF/centerrod_V2.DXF
Team Assignments/Team Assignment 2/Parts/DXF/centerrod_V3.DXF
Team Assignments/Team Assignment 2/Parts/DXF/circle.DXF
Team Assignments/Team Assignment 2/Parts/DXF/stackedcircle.DXF
Team Assignments/Team Assignment 2/Parts/LCD Cover, half.IGS
Team Assignments/Team Assignment 2/Parts/centerrod.DXF
Team Assignments/Team Assignment 2/Parts/centerrod.IGS
Team Assignments/Team Assignment 2/Parts/circle.IGS
Team Assignments/Team Assignment 2/Parts/stackedcircle.IGS
