drawsome1/Carousel/Pictures/closer horse +gear test.png

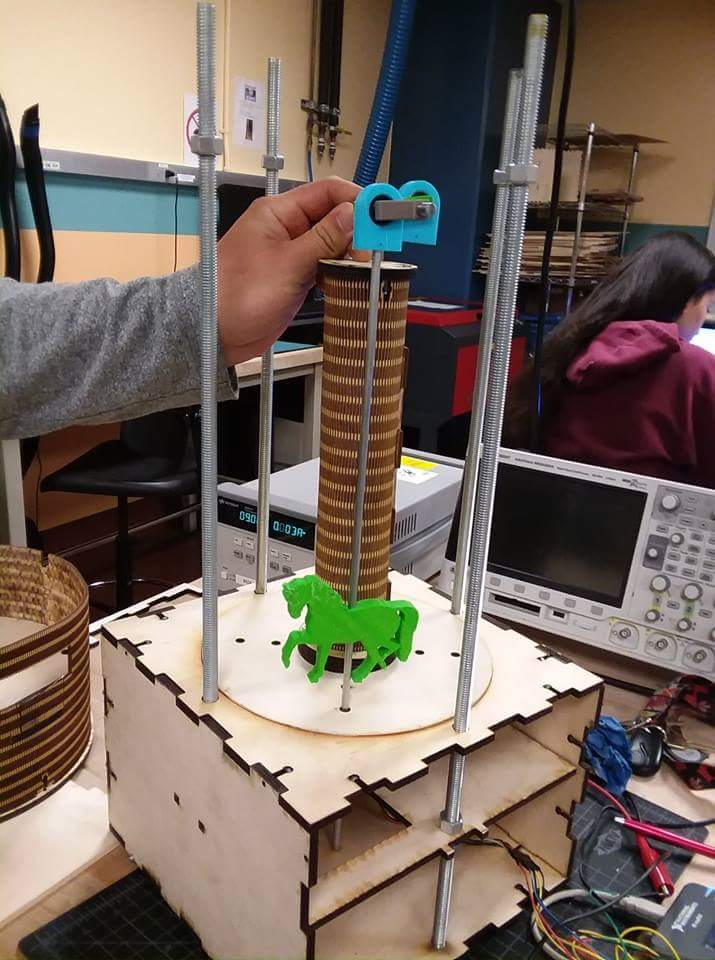
Pictures/closer horse +gear test.png
