drawsome1/Carousel/Pictures/test gears.png

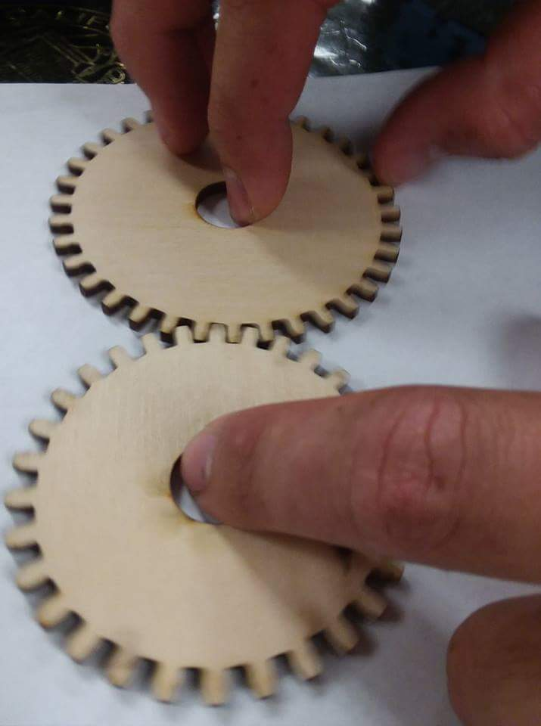
Pictures/test gears.png
