drawsome1/Carousel/Pictures/test horse and gear.png

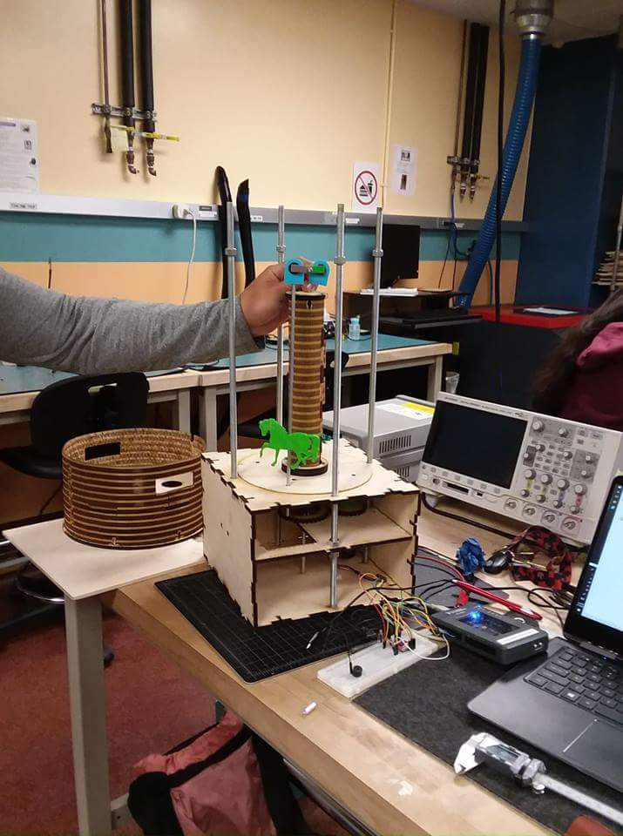
Pictures/test horse and gear.png
