drawsome1/Carousel/Pictures/test living hinge.png

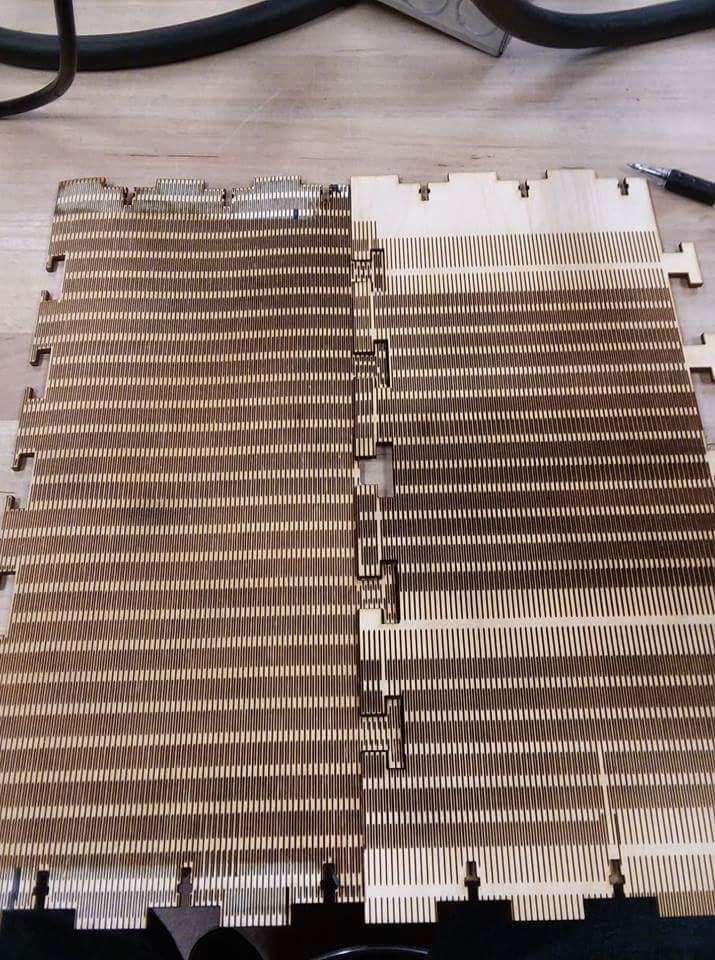
Pictures/test living hinge.png
