drawsome1/Carousel/Team Assignments/Team Assignment 4/Problem 1/Part B.png

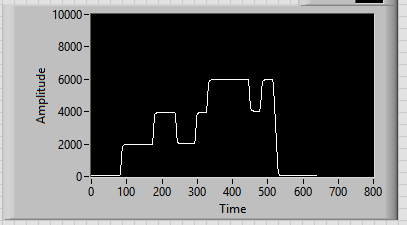
Team Assignments/Team Assignment 4/Problem 1/Part B.png
