drawsome1/Carousel/Team Assignments/Team Assignment 3/Files/ECE 188 Team 1 GANTT CHART.pdf

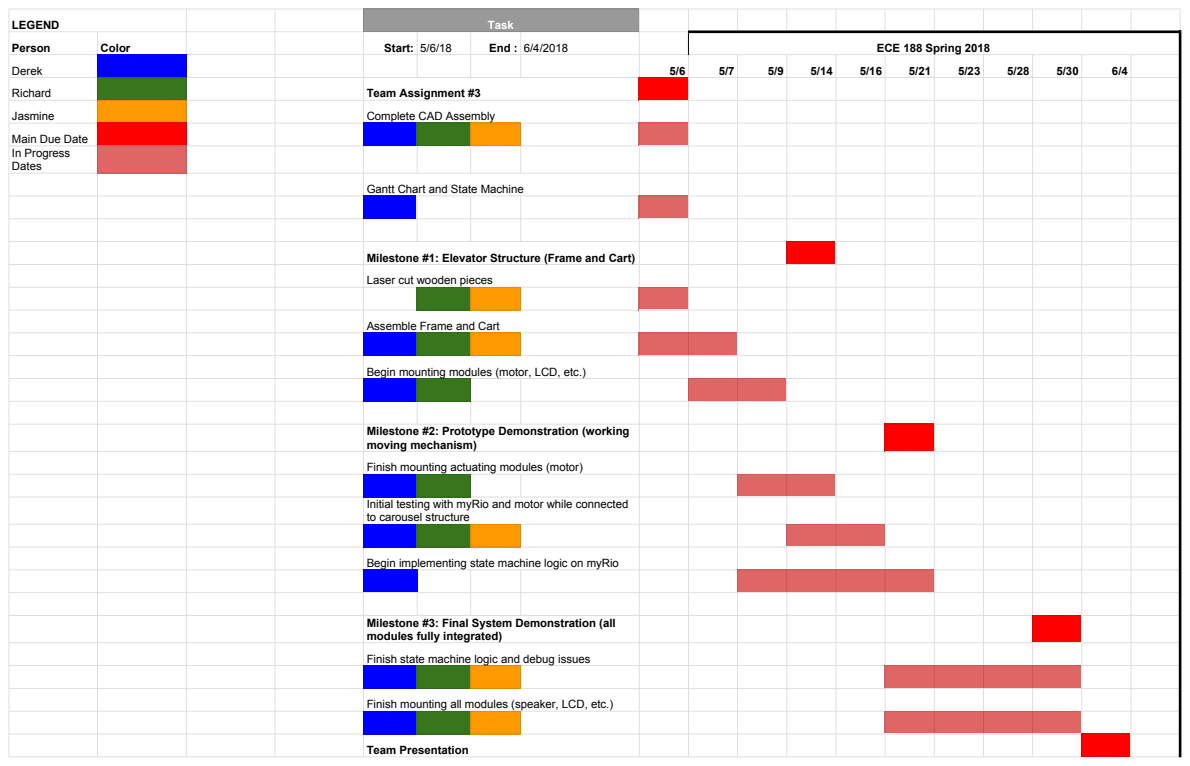
[picture p66: page 1]
LEGEND; Task; Person; Color; Start: 5/6/18; End : 6/4/2018; ECE 188 Spring 2018; Derek; Richard; Team Assignment #3; Jasmine; Complete CAD Assembly; Team Presentation

Main Due Date
In Progress
Dates

Gantt Chart and State Machine

Milestone #1: Elevator Structure (Frame and Cart)

Laser cut wooden pieces

Assemble Frame and Cart

Begin mounting modules (motor, LCD, etc.)

Milestone #2: Prototype Demonstration (working
moving mechanism)

Finish mounting actuating modules (motor)

Initial testing with myRio and motor while connected
to carousel structure

Begin implementing state machine logic on myRio

Milestone #3: Final System Demonstration (all
modules fully integrated)

Finish state machine logic and debug issues

Finish mounting all modules (speaker, LCD, etc.)
