drawsome1/Carousel/Team Assignments/Team Assignment 2/Parts/laser cut/center rod top.pdf

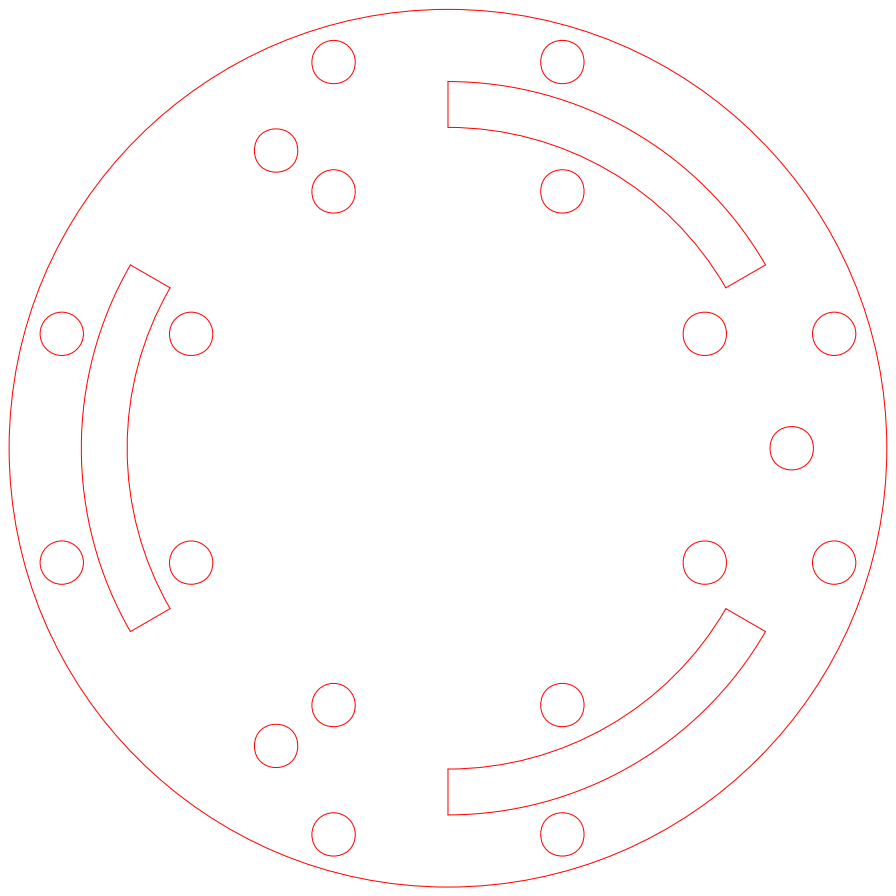
[picture p67: page 1]
