drawsome1/Carousel/Team Assignments/Team Assignment 2/Parts/laser cut/center rod V2 test.pdf

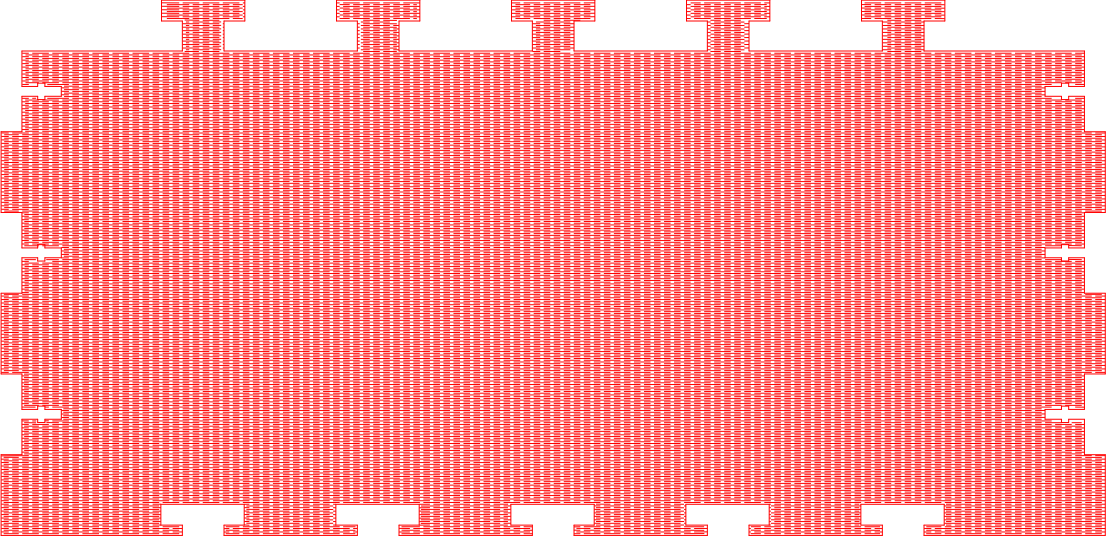
[picture p68: page 1]
