drawsome1/Carousel/Team Assignments/Team Assignment 2/Parts/laser cut/centerrod_V3.7.pdf

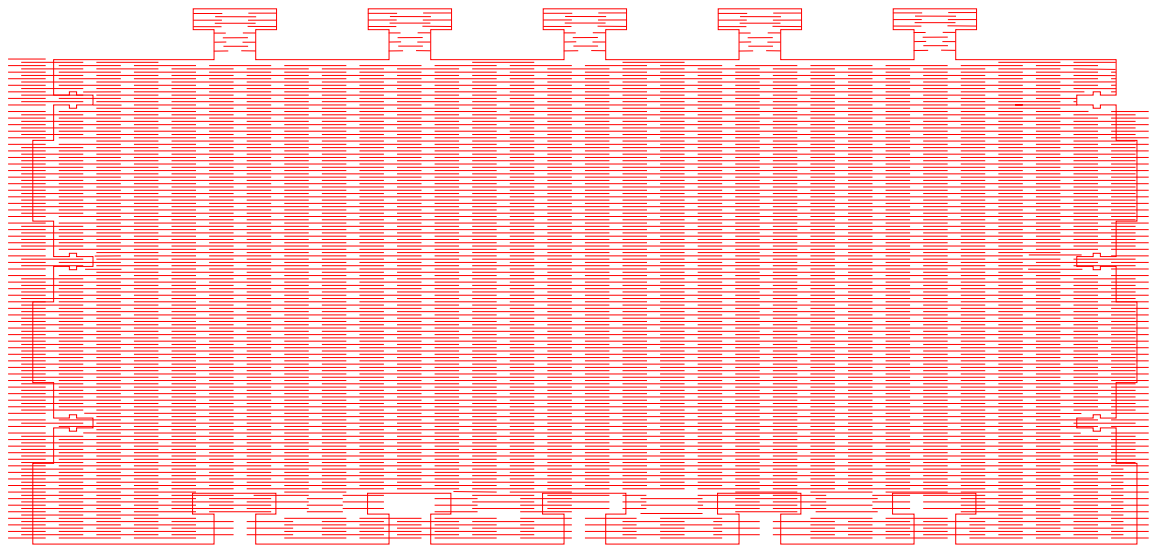
[picture p69: page 1]
