drawsome1/Carousel/Team Assignments/Team Assignment 2/Parts/laser cut/LIVE HINGE IT.pdf

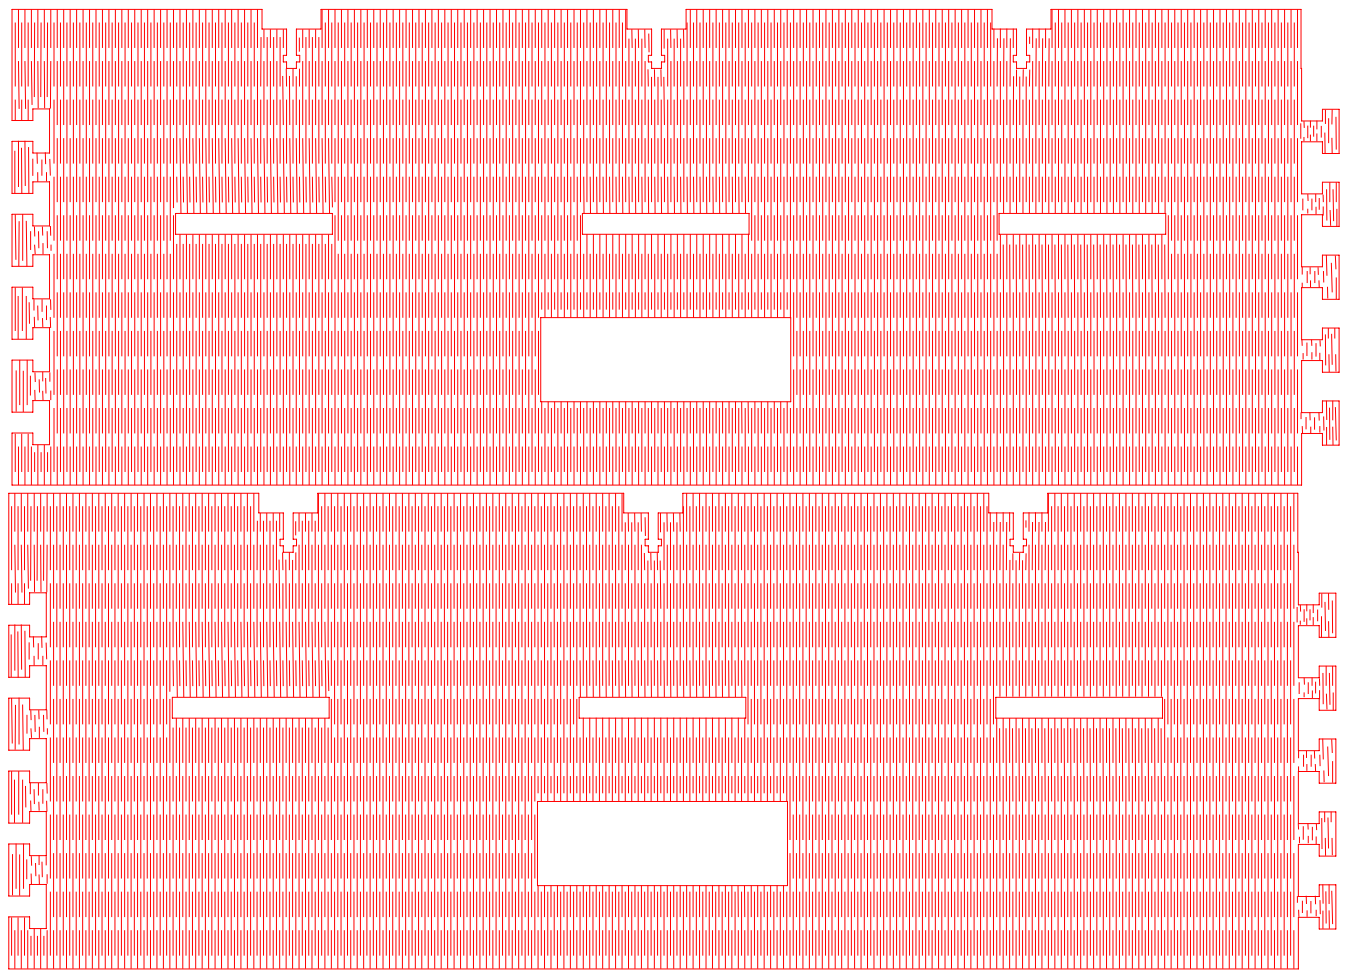
[picture p70: page 1]
