drawsome1/Carousel/Team Assignments/Team Assignment 2/Parts/laser cut/middle + cap _ top.pdf

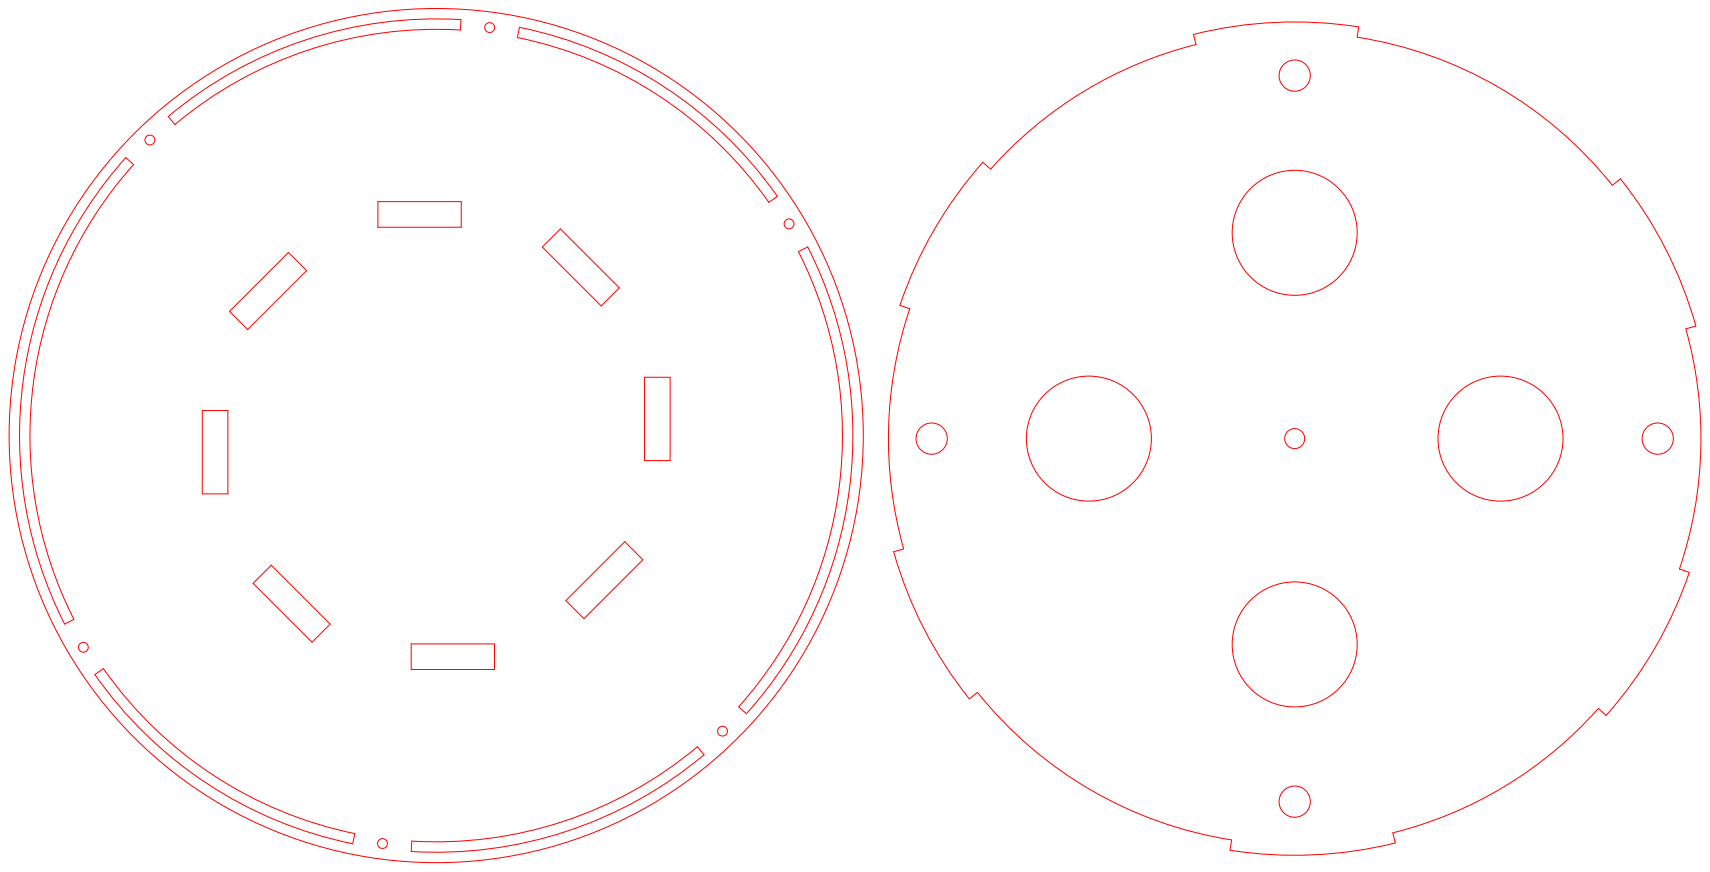
[picture p71: page 1]
