drawsome1/Carousel/Team Assignments/Team Assignment 2/Parts/laser cut/rotating circle + center rod.pdf

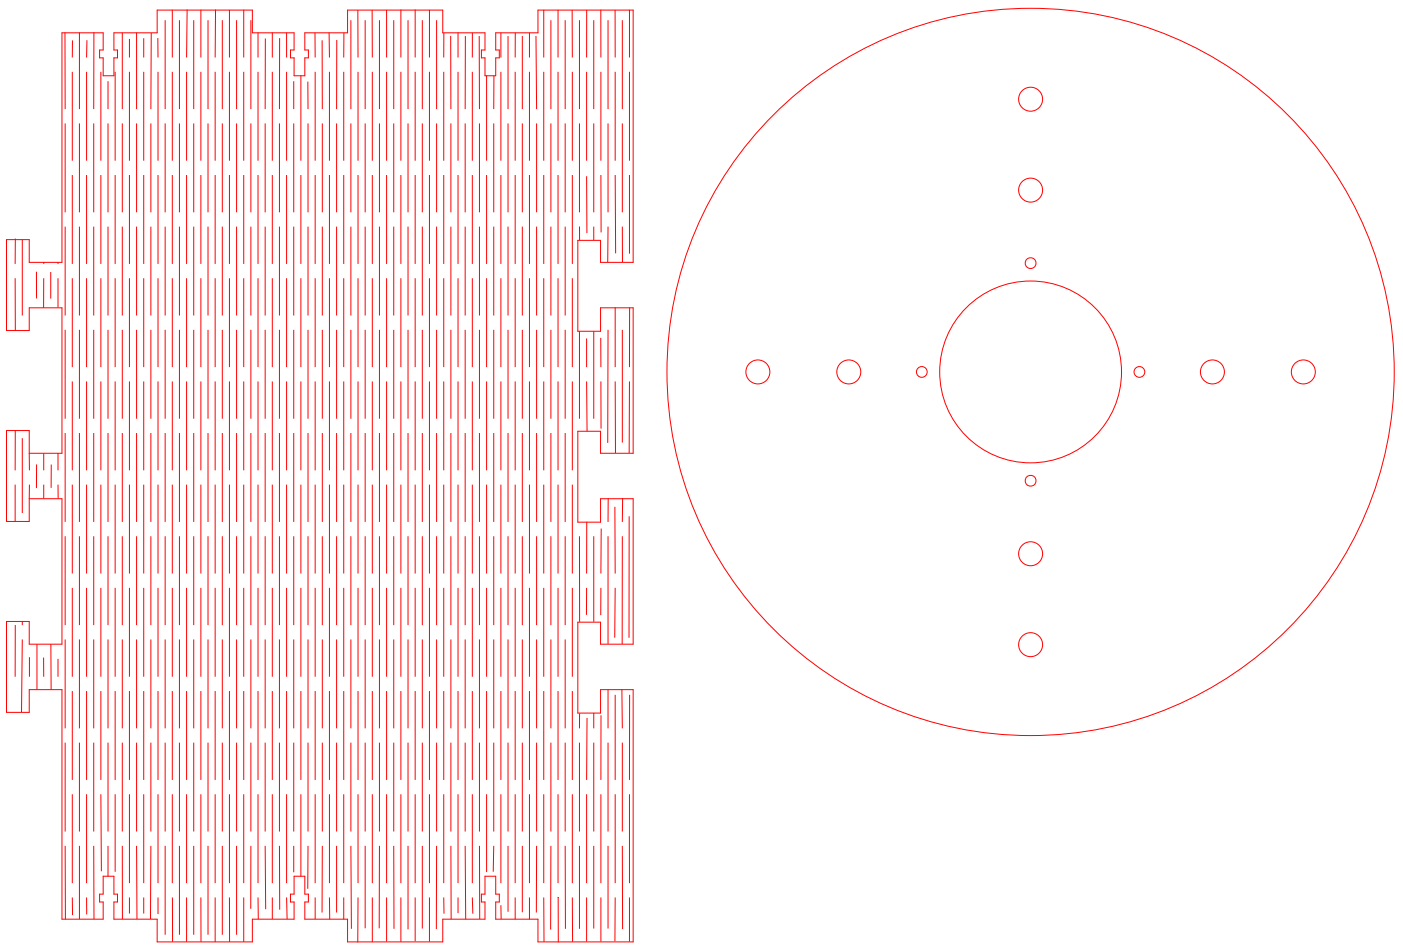
[picture p72: page 1]
