drawsome1/Carousel/Team Assignments/Team Assignment 2/Parts/laser cut/side_bottom + stacked rings + spur gears.pdf

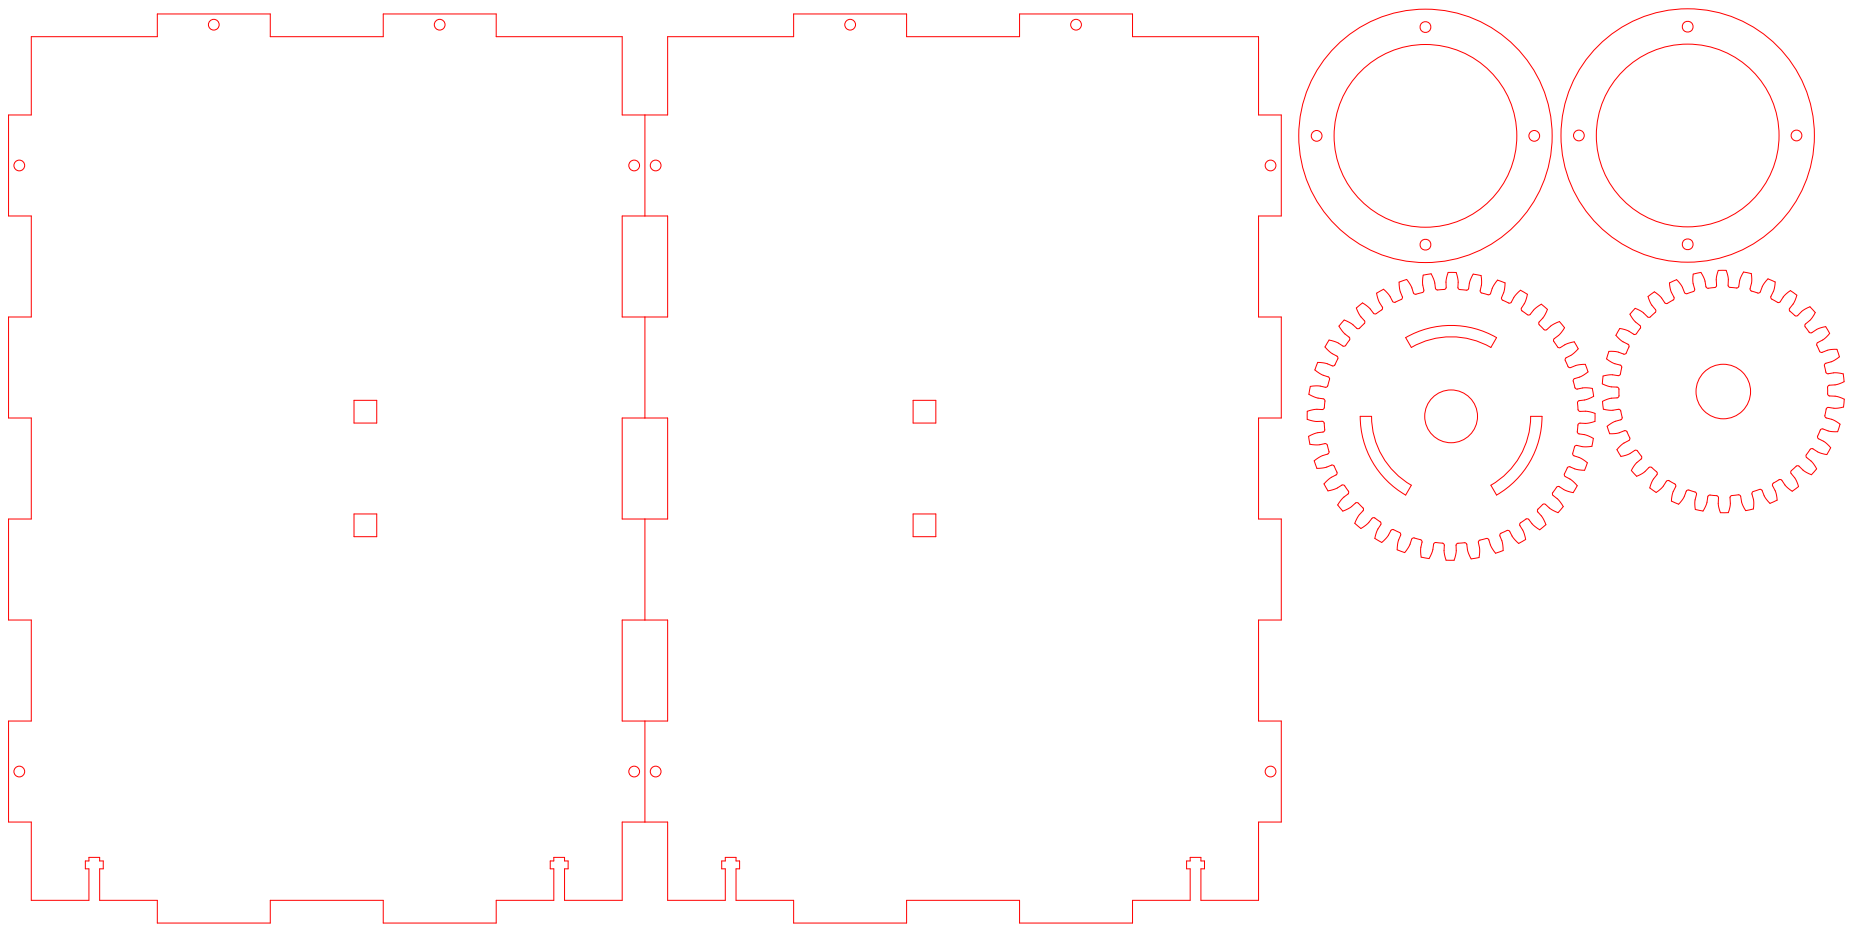
[picture p73: page 1]
