drawsome1/Carousel/Team Assignments/Team Assignment 2/Parts/laser cut/top_top + center rod.pdf

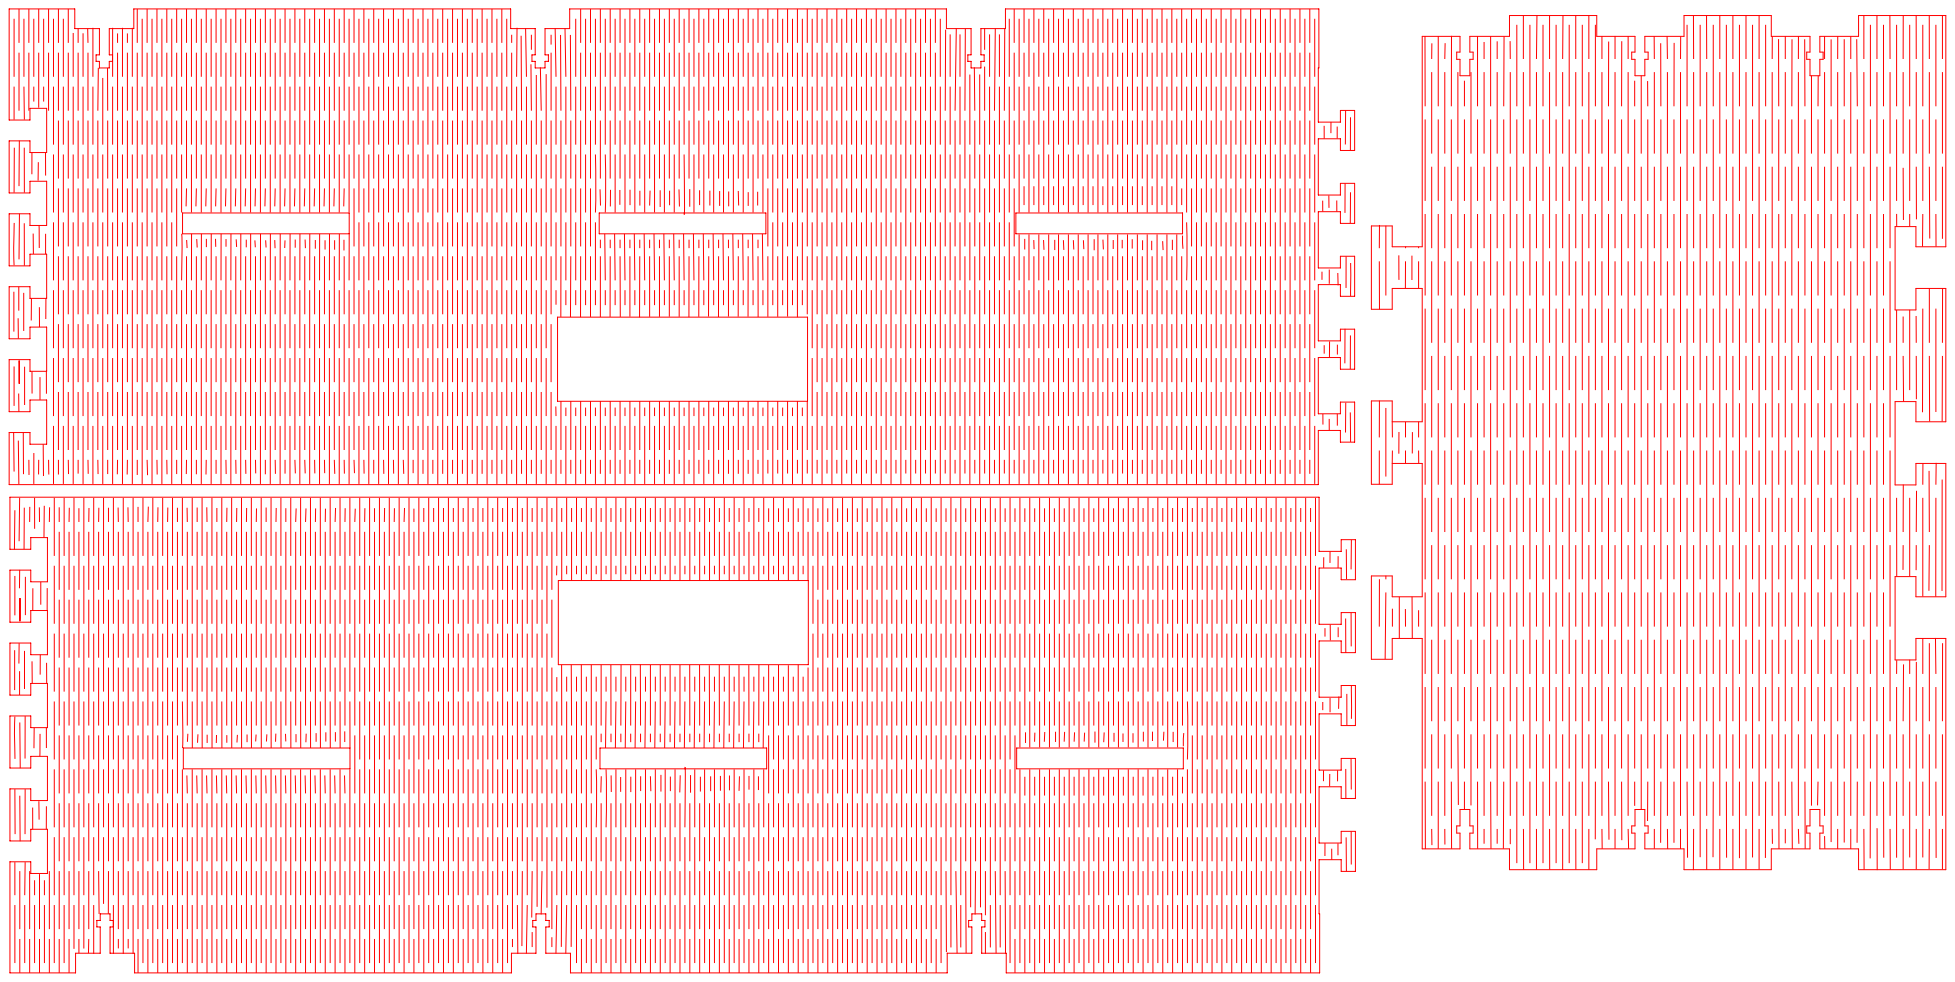
[picture p74: page 1]
