drawsome1/Carousel/Team Assignments/Team Assignment 2/Parts/laser cut/top_top.pdf

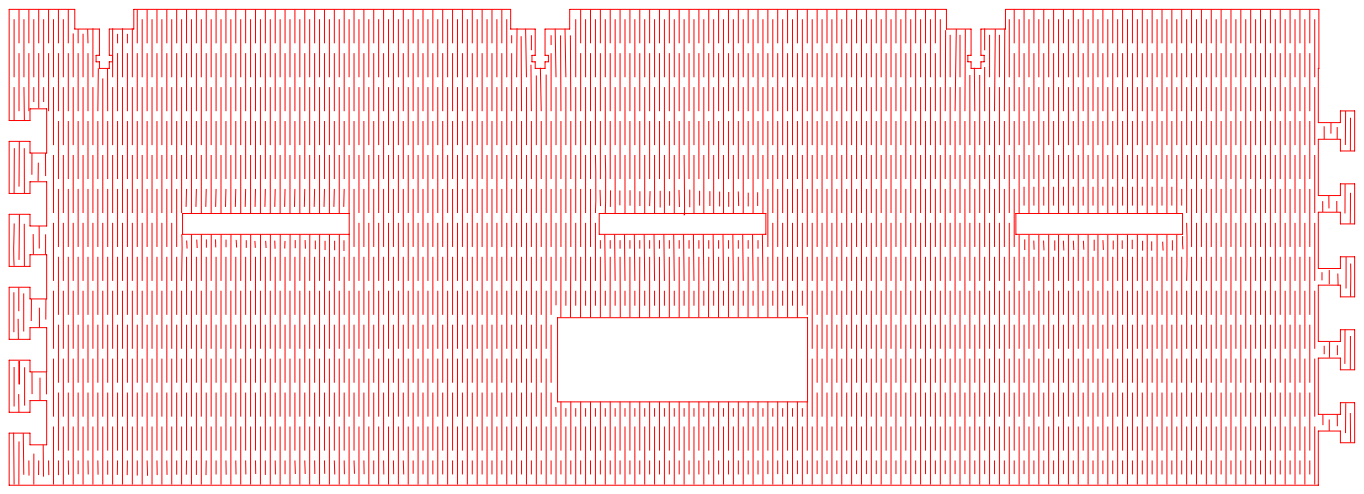
[picture p75: page 1]
