drawsome1/Carousel/Team Assignments/Team Assignment 2/Parts/laser cut/centerrod_V3.5.pdf

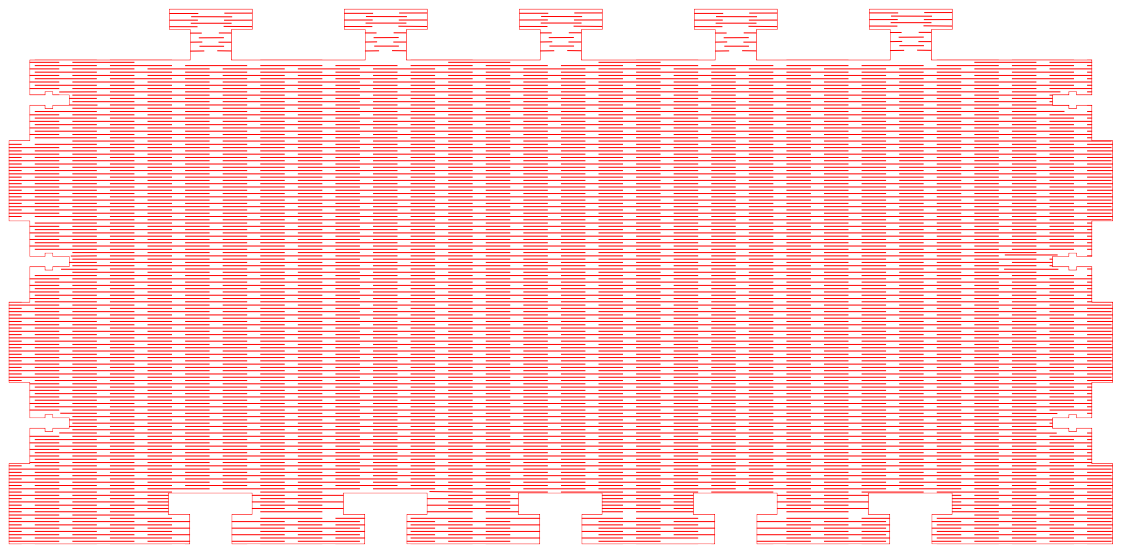
[picture p76: page 1]
