drawsome1/Carousel/(commit log)

2018-07-12 inserting files
    [37d-gearmotor-50-70-encoder.step, BevelGearVertical.stl, Bottom.DXF, CRANKSHAFT half in.IGS, CRANKSHAFT half in.SLDPRT, CRANKSHAFT one in.IGS, CRANKSHAFT one in.SLDPRT, CRANKSHAFT one in.STL]
2018-08-10 can't put a link in a quoted text so took that out, added materials and constraints
